SVIELCOM/MWE_Schema_and_PCB/Parts.txt

TLV9001IDBVR			done
B82790C0225N265			done поправить футпринт и 3D
RID-50B  
SC56-11SRWA 			done
MAX7219EWG+T  			done
PST-11A  			done
LD1117S33CTR			done  	
593D106X9016A2TE3 10x16		done
CL10B105KA8NNNC 1x25		done
STM32H743ZIT6  			done
CC56-12SURKWA  			done
ISO224BDWVR  
ESDA6V1BC6 			done
NX3215SA-32.768K-STD-MUA-14	done
NX5032GA-8MHz			done
TR3D476K025C0150 47x25		done
TMH 2415S 			done		
BC56-11SURKWA			done
W25Q256JVFIQ			done
GRM188R7YA105KA12D 1x35		done
CC0603BRNPO9BN2R7 2.7pF		done
L-1154ID			done
593D476X9016D2TE3 47x16		done
ISO1211DR 			done
LAN8742A-CZ-TR			done
