SVIELCOM/MWE_Schema_and_PCB/Analog_decoupling.ods

"U2" | "ISO224ADWVR" | ""
"J1" | "22-23-2021" | ""
"U5" | "ISO224ADWVR" | ""
"J2" | "22-23-2021" | ""
"U9" | "ISO224ADWVR" | ""
"J3" | "22-23-2021" | ""
"J4" | "302-S101" | ""
"J5" | "OSTTC020162" | ""
"C2" | "10µFx35" | "293D106X9035D2TE3"
"C21" | "10µFx35" | "293D106X9035D2TE3"
"C12" | "10µFx35" | "293D106X9035D2TE3"
"C4" | "10µFx35" | "293D106X9035D2TE3"
"C6" | "10µFx16" | "593D106X9016A2TE3"
"L1" | "B82790C0225N265" | "B82790C0225N265"
"L2" | "B82790C0225N265" | "B82790C0225N265"
"L3" | "B82790C0225N265" | "B82790C0225N265"
"C8" | "0.22µF" | "C1608X7R1H224K080AB"
"C15" | "0.22µF" | "C1608X7R1H224K080AB"
"C24" | "0.22µF" | "C1608X7R1H224K080AB"
"C7" | "0.1µF" | "CL10B104KC8NNNC"
"C14" | "0.1µF" | "CL10B104KC8NNNC"
"C23" | "0.1µF" | "CL10B104KC8NNNC"
"C18" | "1µF" | "CL10B105KA8NNNC"
"C3" | "1µF" | "GRM188R7YA105KA12D"
"C1" | "1µF" | "GRM188R7YA105KA12D"
"C5" | "1µF" | "GRM188R7YA105KA12D"
"C11" | "1µF" | "GRM188R7YA105KA12D"
"C10" | "1µF" | "GRM188R7YA105KA12D"
"C13" | "1µF" | "GRM188R7YA105KA12D"
"C20" | "1µF" | "GRM188R7YA105KA12D"
"C19" | "1µF" | "GRM188R7YA105KA12D"
"C22" | "1µF" | "GRM188R7YA105KA12D"
"C17" | "1µF" | "GRM188R7YA105KA12D"
"R3" | "1K" | "MFR-25FTF52-1K"
"R17" | "1K" | "MFR-25FTF52-1K"
"R31" | "1K" | "MFR-25FTF52-1K"
"R2" | "825" | "RC0603FR-07825RL"
"R7" | "825" | "RC0603FR-07825RL"
"R16" | "825" | "RC0603FR-07825RL"
"R30" | "825" | "RC0603FR-07825RL"
"R21" | "825" | "RC0603FR-07825RL"
"R35" | "825" | "RC0603FR-07825RL"
"R5" | "1.1K" | "RC0805FR-071K1L"
"R19" | "1.1K" | "RC0805FR-071K1L"
"R33" | "1.1K" | "RC0805FR-071K1L"
"R14" | "1K" | "RC0805FR-071KL"
"R13" | "1K" | "RC0805FR-071KL"
"R12" | "1K" | "RC0805FR-071KL"
"R28" | "1K" | "RC0805FR-071KL"
"R27" | "1K" | "RC0805FR-071KL"
"R26" | "1K" | "RC0805FR-071KL"
"R42" | "1K" | "RC0805FR-071KL"
"R41" | "1K" | "RC0805FR-071KL"
"R40" | "1K" | "RC0805FR-071KL"
"R11" | "2K" | "RC0805FR-072KL"
"R25" | "2K" | "RC0805FR-072KL"
"R39" | "2K" | "RC0805FR-072KL"
"R10" | "3.3K" | "RT0603BRD073K3L"
"R1" | "3.3K" | "RT0603BRD073K3L"
"R15" | "3.3K" | "RT0603BRD073K3L"
"R29" | "3.3K" | "RT0603BRD073K3L"
"R24" | "3.3K" | "RT0603BRD073K3L"
"R38" | "3.3K" | "RT0603BRD073K3L"
"R4" | "10K" | "RT0805BRB0710KL"
"R6" | "10K" | "RT0805BRB0710KL"
"R8" | "10K" | "RT0805BRB0710KL"
"R9" | "10K" | "RT0805BRB0710KL"
"R18" | "10K" | "RT0805BRB0710KL"
"R20" | "10K" | "RT0805BRB0710KL"
"R22" | "10K" | "RT0805BRB0710KL"
"R23" | "10K" | "RT0805BRB0710KL"
"R32" | "10K" | "RT0805BRB0710KL"
"R34" | "10K" | "RT0805BRB0710KL"
"R36" | "10K" | "RT0805BRB0710KL"
"R37" | "10K" | "RT0805BRB0710KL"
"U4" | "TLV9001IDBVR"
"PS1" | "TMH2415S"
"U1" | "LT1129CST-5#PBF"
"U8" | "REF1933AIDDCT"
"D2" | "1N4743A"
"D1" | "1N4743A"
"U3" | "TLV9001IDBVR"
"U7" | "TLV9001IDBVR"
"PS2" | "TMH2415S"
"U6" | "TLV9001IDBVR"
"U11" | "TLV9001IDBVR"
"PS3" | "TMH2415S"
"U10" | "TLV9001IDBVR"
"D4" | "1N4743A"
"D3" | "1N4743A"
"D6" | "1N4743A"
"D5" | "1N4743A"
