SVIELCOM/MWE_Schema_and_PCB/Schema_and_PCB.ods

U11 | "STM32H743ZIT6" | ""
C1 | "10┬╡F" | "593D106X9016A2TE3"
C32 | "10┬╡F" | "593D106X9016A2TE3"
C34 | "10┬╡F" | "593D106X9016A2TE3"
C28 | "10┬╡F" | "593D106X9016A2TE3"
C12 | "10┬╡Fx16" | "593D106X9016A2TE3"
C16 | "10┬╡Fx16" | "593D106X9016A2TE3"
C9 | "10┬╡Fx16" | "593D106X9016A2TE3"
C8 | "10┬╡Fx16" | "593D106X9016A2TE3"
C51 | "10┬╡Fx16" | "593D106X9016A2TE3"
C88 | "10┬╡F" | "593D106X9016A2TE3"
C11 | "47┬╡Fx16" | "593D476X9016D2TE3"
C15 | "47┬╡Fx16" | "593D476X9016D2TE3"
L1 | "600R@100MHz" | "BK2125HS601-T"
L2 | "600R@100MHz" | "BK2125HS601-T"
L3 | "600R@100MHz" | "BK2125HS601-T"
L6 | "600R@100MHz" | "BK2125HS601-T"
C7 | "2.7pF" | "CC0603BRNPO9BN2R7"
C10 | "2.7pF" | "CC0603BRNPO9BN2R7"
C5 | "4.6pF" | "CC0603CRNPO9BN4R7"
C6 | "4.6pF" | "CC0603CRNPO9BN4R7"
C95 | "5.6pF" | "CC0603CRNPO9BN5R6"
C92 | "5.6pF" | "CC0603CRNPO9BN5R6"
C14 | "0.1┬╡F" | "CL10B104KC8NNNC"
C54 | "0.1┬╡F" | "CL10B104KC8NNNC"
C66 | "0.1┬╡F" | "CL10B104KC8NNNC"
C74 | "0.1┬╡F" | "CL10B104KC8NNNC"
C79 | "0.1┬╡F" | "CL10B104KC8NNNC"
C80 | "0.1┬╡F" | "CL10B104KC8NNNC"
C81 | "0.1┬╡F" | "CL10B104KC8NNNC"
C82 | "0.1┬╡F" | "CL10B104KC8NNNC"
C83 | "0.1┬╡F" | "CL10B104KC8NNNC"
C84 | "0.1┬╡F" | "CL10B104KC8NNNC"
C43 | "1┬╡F" | "CL10B105KA8NNNC"
C44 | "1┬╡F" | "CL10B105KA8NNNC"
C2 | "1┬╡F" | "CL10B105KA8NNNC"
C31 | "1┬╡F" | "CL10B105KA8NNNC"
C33 | "1┬╡F" | "CL10B105KA8NNNC"
C18 | "1┬╡F" | "CL10B105KA8NNNC"
C19 | "1┬╡F" | "CL10B105KA8NNNC"
C20 | "1┬╡F" | "CL10B105KA8NNNC"
C21 | "1┬╡F" | "CL10B105KA8NNNC"
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
R110 | "50K"
R107 | "50K"
R108 | "50K"
R23 | "82K"
R27 | "15K"
R57 | "10K"
R61 | "10K"
BT1 | "CR2032"
U4 | "BC56-12SURKWA"
U14 | "SN74AVCA406DGGR"
U9 | "ST1L05APU33R"
TP4 | "TestPoint"
TP2 | "TestPoint"
TP3 | "TestPoint"
TP1 | "TestPoint"
TP7 | "TestPoint"
TP16 | "TestPoint"
TP19 | "TestPoint"
