SVIELCOM/MWE_Schema_and_PCB/(list of files, drawings)

Other design files:
PCB.dsn
