SVIELCOM/MWE_Schema_and_PCB/Analog_decoupling.kicad_pcb

## KiCad design Analog_decoupling.kicad_pcb (2022-03-23)

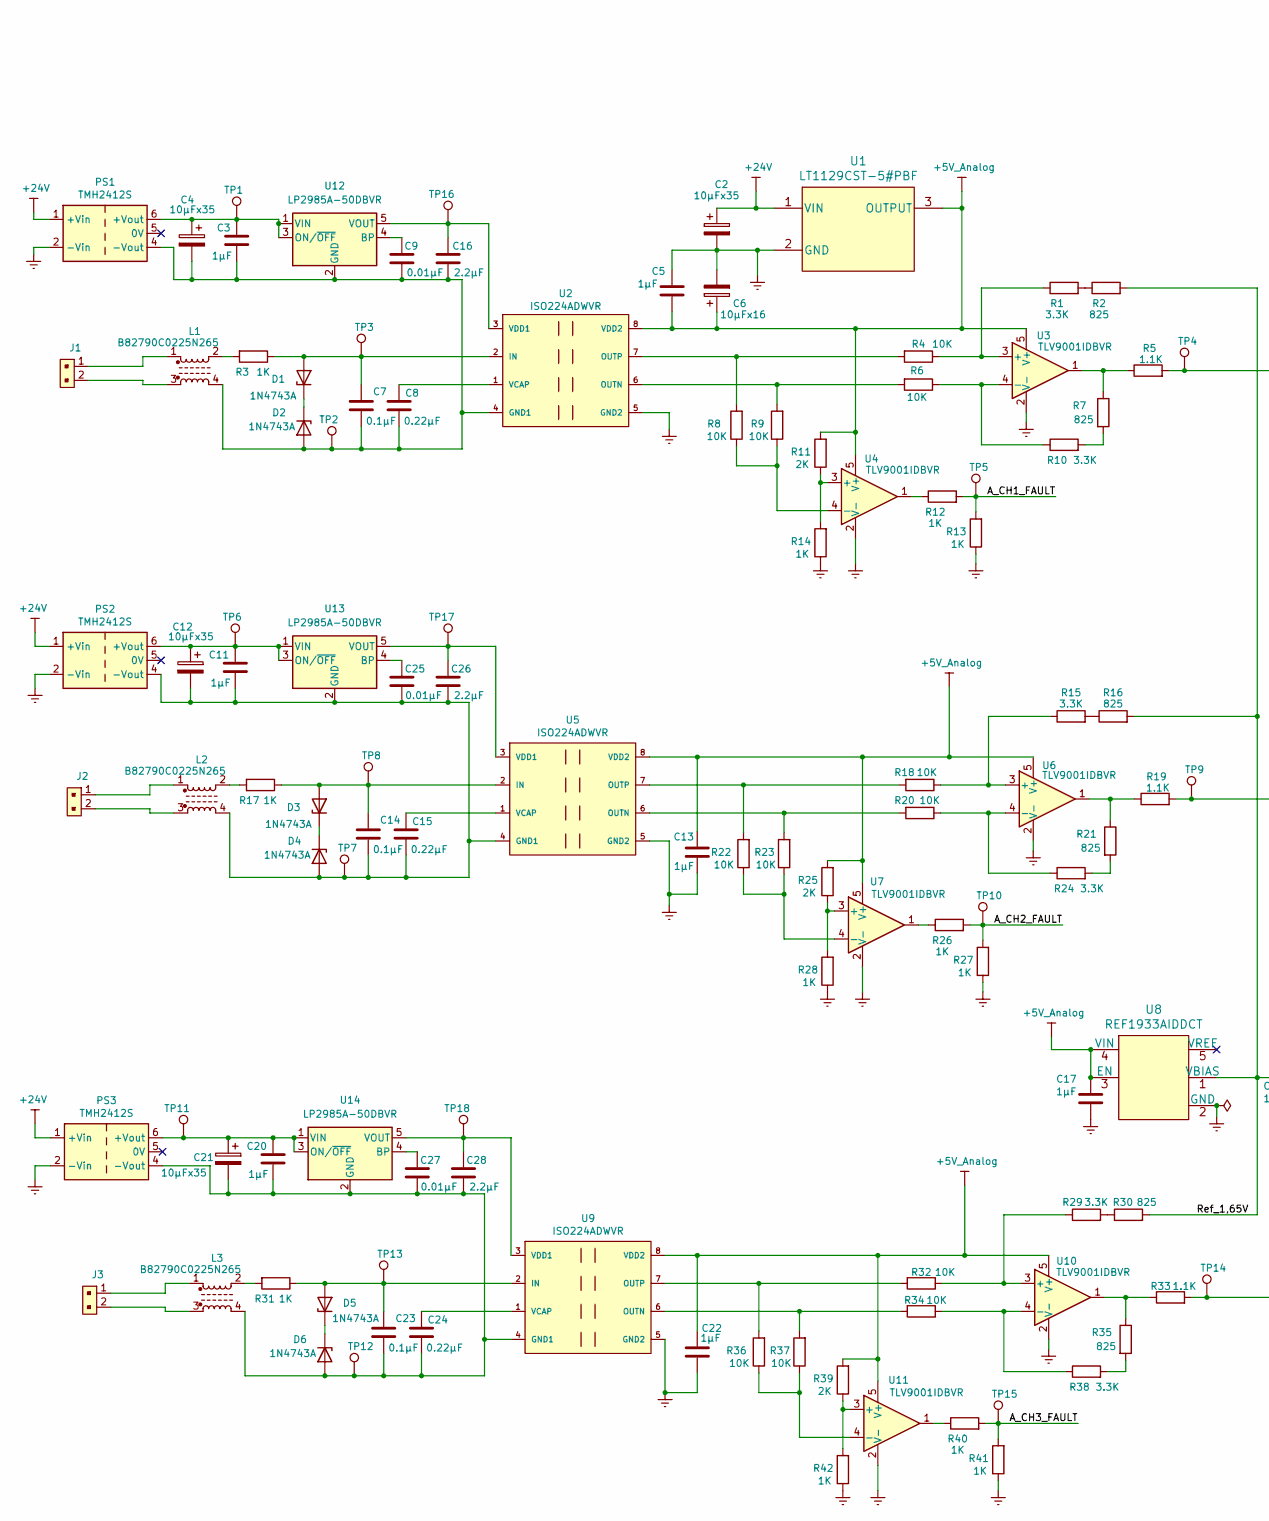
[picture p1: schematic Analog_decoupling.kicad_sch, ШВУ, part in row 1, column 1]

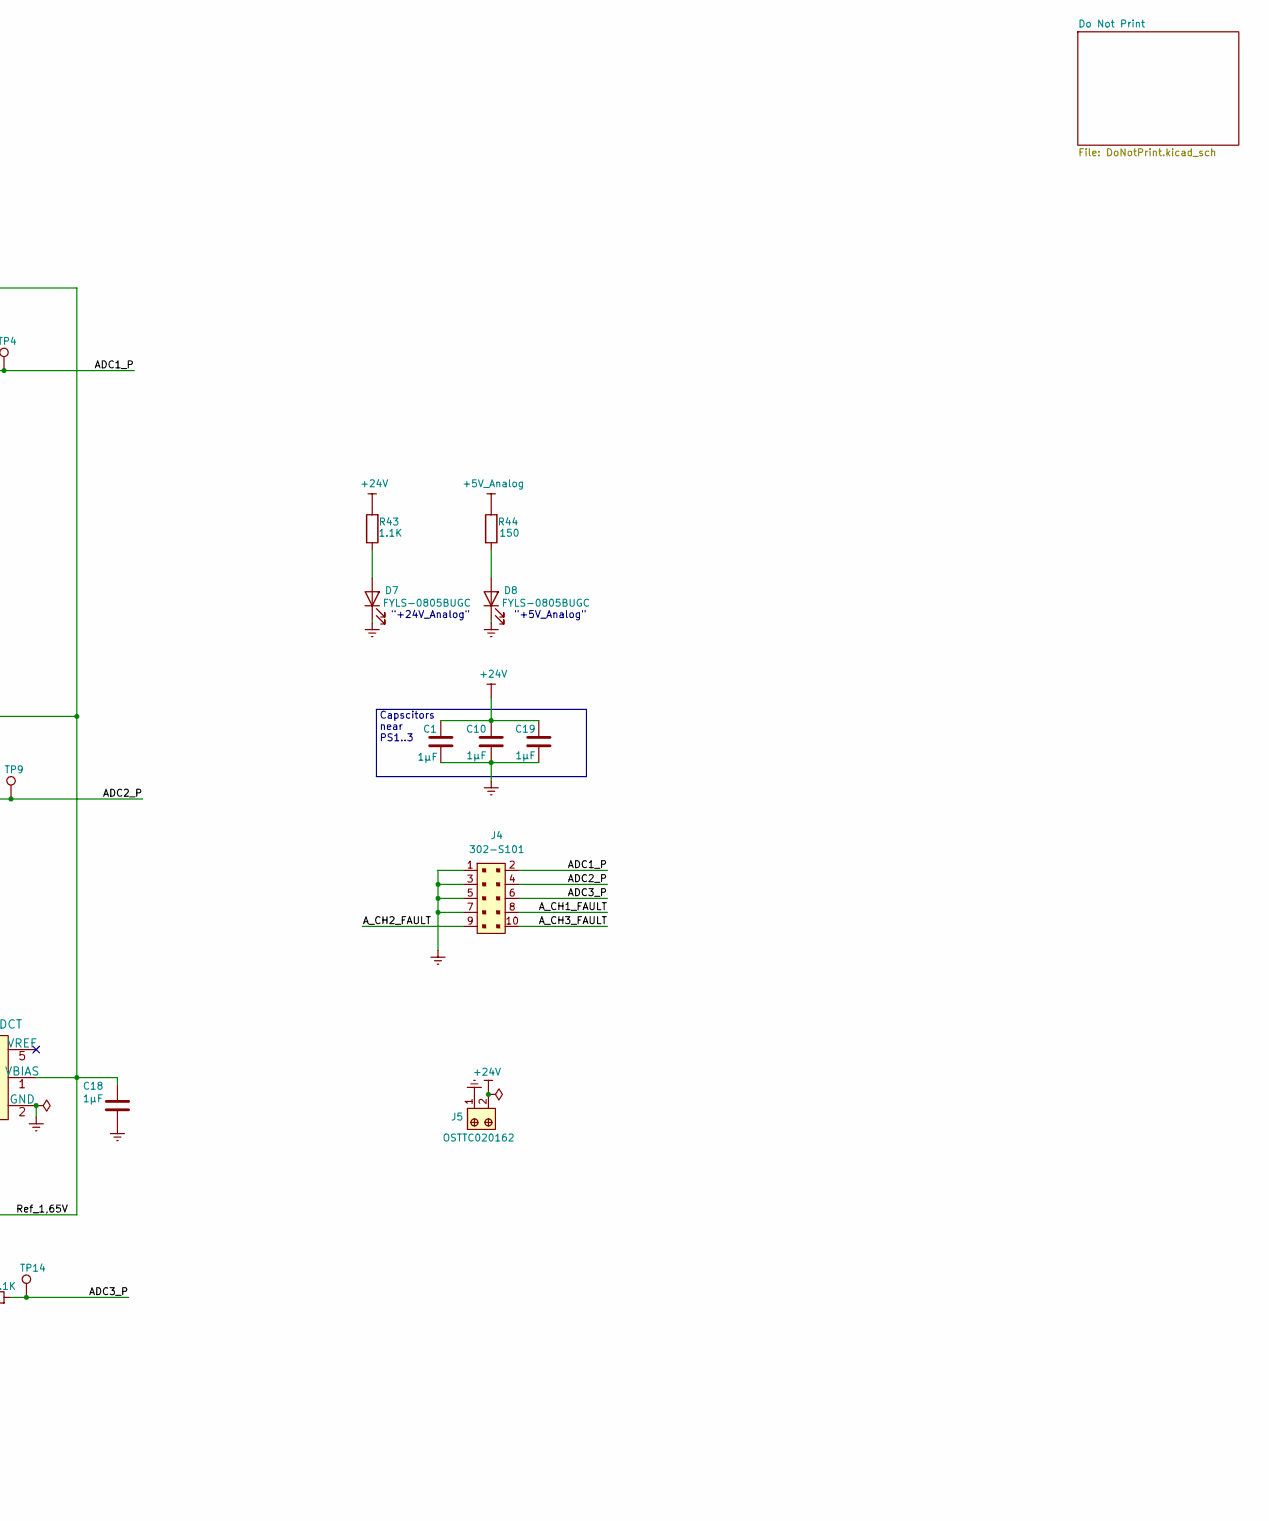
[picture p2: schematic Analog_decoupling.kicad_sch, ШВУ, part in row 1, column 2]

Parts:
C1, C3, C5, C10, C11, C13, C17, C18, C19, C20, C22: 1µF; C_0603_1608Metric_Pad1.08x0.95mm_HandSolder
C2, C4, C12, C21: 10µFx35; CP_EIA-7343-30_AVX-N_Pad2.25x2.55mm_HandSolder
C6: 10µFx16; CP_EIA-3216-10_Kemet-I
C7, C14, C23: 0.1µF; C_0603_1608Metric_Pad1.08x0.95mm_HandSolder
C8, C15, C24: 0.22µF; C_0603_1608Metric_Pad1.08x0.95mm_HandSolder
C9, C25, C27: 0.01µF; C_0603_1608Metric
C16, C26, C28: 2.2µF; C_0603_1608Metric
D1, D2, D3, D4, D5, D6: 1N4743A; D_DO-41_SOD81_P10.16mm_Horizontal
D7, D8: FYLS-0805BUGC; LED_0805_2012Metric
J1, J2, J3: 22-23-2021; PinHeader_1x2_P2.54mm_Drill1.02mm; MPN 22-23-2021; Digi-Key_PN WM4200-ND
J4: 302-S101; PinHeader_2x5_P2.54mm_Drill1.2mm; MPN 302-S101; Digi-Key_PN ED1543-ND
J5: OSTTC020162; Term_Block_1x2_P5mm; MPN OSTTC020162; Digi-Key_PN ED2600-ND
L1, L2, L3: B82790C0225N265
PS1, PS2, PS3: TMH2412S; Converter_DCDC_XP_POWER-IAxxxxS_THT
R1, R10, R15, R24, R29, R38: 3.3K; R_0603_1608Metric
R2, R7, R16, R21, R30, R35: 825; R_0603_1608Metric
R3, R17, R31: 1K; R_Axial_DIN0207_L6.3mm_D2.5mm_P10.16mm_Horizontal
R4, R6, R8, R9, R18, R20, R22, R23, R32, R34, R36, R37: 10K; R_0805_2012Metric
R5, R19, R33, R43: 1.1K; R_0805_2012Metric
R11, R25, R39: 2K; R_0805_2012Metric
R12, R13, R14, R26, R27, R28, R40, R41, R42: 1K; R_0805_2012Metric
R44: 150; R_0805_2012Metric
TP1, TP2, TP3, TP4, TP5, TP6, TP7, TP8, TP9, TP10, TP11, TP12, TP13, TP14, TP15, TP16, TP17, TP18: TestPoint; TestPoint_Pad_D1.5mm
U1: LT1129CST-5#PBF; SOT-223-3_TabPin2
U2, U5, U9: ISO224ADWVR; Texas_Instruments-DWV0008A-0-0-IPC_A; voltage gain 0.001/3V/mV; mouser part number 595-ISO224ADWVR; digikey description IC ISOLATED 8SOIC
U3, U4, U6, U7, U10, U11: TLV9001IDBVR; SOT-23-5
U8: REF1933AIDDCT; SOT-23-5_HandSoldering
U12, U13, U14: LP2985A-50DBVR; SOT-23-5

Connections:
+5V_Analog: C5.2, C6.1, C13.2, C17.1, C22.2, R11.2, R25.2, R39.2, R44.2, U1.3 (OUTPUT), U2.8 (VDD2), U3.5 (V+), U4.5 (V+), U5.8 (VDD2), U6.5 (V+), U7.5 (V+), U8.3 (EN), U8.4 (VIN), U9.8 (VDD2), U10.5 (V+), U11.5 (V+)
+24V: C1.1, C2.1, C10.1, C19.1, J5.2, PS1.1 (+Vin), PS2.1 (+Vin), PS3.1 (+Vin), R43.2, U1.1 (VIN)
/ADC1_P: J4.2, R5.2, TP4.1
/ADC2_P: J4.4, R19.2, TP9.1
/ADC3_P: J4.6, R33.2, TP14.1
/A_CH1_FAULT: J4.8, R12.2, R13.2, TP5.1
/A_CH2_FAULT: J4.9, R26.2, R27.2, TP10.1
/A_CH3_FAULT: J4.10, R40.2, R41.2, TP15.1
/Ref_1,65V: C18.1, R2.2, R16.2, R30.2, U8.1 (VBIAS)
GNDREF: C1.2, C2.2, C5.1, C6.2, C10.2, C13.1, C17.2, C18.2, C19.2, C22.1, D7.1 (K), D8.1 (K), J4.1, J4.3, J4.5, J4.7, J5.1, PS1.2 (-Vin), PS2.2 (-Vin), PS3.2 (-Vin), R13.1, R14.1, R27.1, R28.1, R41.1, R42.1, U1.2 (GND), U2.5 (GND2), U3.2 (V-), U4.2 (V-), U5.5 (GND2), U6.2 (V-), U7.2 (V-), U8.2 (GND), U9.5 (GND2), U10.2 (V-), U11.2 (V-)
unnamed: C3.1, C4.1, PS1.6 (+Vout), TP1.1, U12.1 (VIN), U12.3 (ON/~OFF)
unnamed: C7.1, D1.2 (A), R3.1, TP3.1, U2.2 (IN)
unnamed: C8.1, U2.1 (VCAP)
unnamed: C9.1, U12.4 (BP)
unnamed: C11.1, C12.1, PS2.6 (+Vout), TP6.1, U13.1 (VIN), U13.3 (ON/~OFF)
unnamed: C11.2, C12.2, C14.2, C15.2, C25.2, C26.2, D4.2 (A), L2.4, PS2.4 (-Vout), TP7.1, U5.4 (GND1), U13.2 (GND)
unnamed: C14.1, D3.2 (A), R17.1, TP8.1, U5.2 (IN)
unnamed: C15.1, U5.1 (VCAP)
unnamed: C16.1, TP16.1, U2.3 (VDD1), U12.5 (VOUT)
unnamed: C3.2, C4.2, C7.2, C8.2, C9.2, C16.2, D2.2 (A), L1.4, PS1.4 (-Vout), TP2.1, U2.4 (GND1), U12.2 (GND)
unnamed: C20.1, C21.1, PS3.6 (+Vout), TP11.1, U14.1 (VIN), U14.3 (ON/~OFF)
unnamed: C20.2, C21.2, C23.2, C24.2, C27.2, C28.2, D6.2 (A), L3.4, PS3.4 (-Vout), TP12.1, U9.4 (GND1), U14.2 (GND)
unnamed: C23.1, D5.2 (A), R31.1, TP13.1, U9.2 (IN)
unnamed: C24.1, U9.1 (VCAP)
unnamed: C25.1, U13.4 (BP)
unnamed: C26.1, TP17.1, U5.3 (VDD1), U13.5 (VOUT)
unnamed: C27.1, U14.4 (BP)
unnamed: C28.1, TP18.1, U9.3 (VDD1), U14.5 (VOUT)
unnamed: D1.1 (K), D2.1 (K)
unnamed: D3.1 (K), D4.1 (K)
unnamed: D5.1 (K), D6.1 (K)
unnamed: D7.2 (A), R43.1
unnamed: D8.2 (A), R44.1
unnamed: J1.1, L1.1
unnamed: J1.2, L1.3
unnamed: J2.1, L2.1
unnamed: J2.2, L2.3
unnamed: J3.1, L3.1
unnamed: J3.2, L3.3
unnamed: L1.2, R3.2
unnamed: L2.2, R17.2
unnamed: L3.2, R31.2
unnamed: R1.1, R4.1, U3.3 (+)
unnamed: R1.2, R2.1
unnamed: R4.2, R8.2, U2.7 (OUTP)
unnamed: R5.1, R7.1, U3.1
unnamed: R6.2, R9.2, U2.6 (OUTN)
unnamed: R8.1, R9.1, U4.4 (-)
unnamed: R6.1, R10.1, U3.4 (-)
unnamed: R7.2, R10.2
unnamed: R11.1, R14.2, U4.3 (+)
unnamed: R12.1, U4.1
unnamed: R15.1, R18.1, U6.3 (+)
unnamed: R15.2, R16.1
unnamed: R18.2, R22.2, U5.7 (OUTP)
unnamed: R19.1, R21.1, U6.1
unnamed: R20.1, R24.1, U6.4 (-)
unnamed: R20.2, R23.2, U5.6 (OUTN)
unnamed: R21.2, R24.2
unnamed: R22.1, R23.1, U7.4 (-)
unnamed: R25.1, R28.2, U7.3 (+)
unnamed: R26.1, U7.1
unnamed: R29.1, R32.1, U10.3 (+)
unnamed: R29.2, R30.1
unnamed: R32.2, R36.2, U9.7 (OUTP)
unnamed: R33.1, R35.1, U10.1
unnamed: R34.1, R38.1, U10.4 (-)
unnamed: R34.2, R37.2, U9.6 (OUTN)
unnamed: R35.2, R38.2
unnamed: R36.1, R37.1, U11.4 (-)
unnamed: R39.1, R42.2, U11.3 (+)
unnamed: R40.1, U11.1

Notes on the sheet:
"+24V_Analog"
Capscitors near PS1..3
"+5V_Analog"

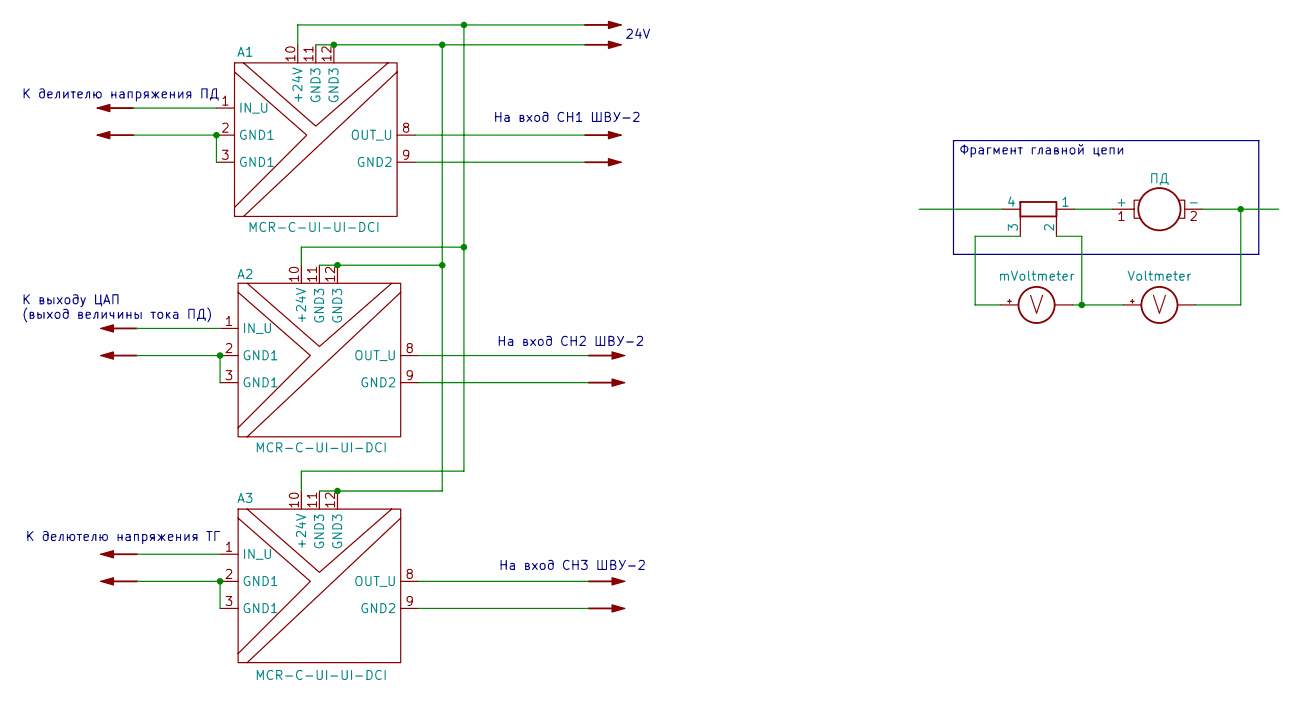
[picture p3: schematic DoNotPrint.kicad_sch]

Parts:
A1, A2, A3: MCR-C-UI-UI-DCI
M1: ПД
MES1: mVoltmeter
MES2: Voltmeter
R45: R_Shunt

Connections:
unnamed: A1.2 (GND1), A1.3 (GND1)
unnamed: A1.10 (+24V), A2.10 (+24V), A3.10 (+24V)
unnamed: A1.11 (GND3), A1.12 (GND3), A2.11 (GND3), A2.12 (GND3), A3.11 (GND3), A3.12 (GND3)
unnamed: A2.2 (GND1), A2.3 (GND1)
unnamed: A3.2 (GND1), A3.3 (GND1)
unnamed: M1.1 (+), R45.1
unnamed: M1.2 (-), MES2.1 (-)
unnamed: MES1.1 (-), MES2.2 (+), R45.2
unnamed: MES1.2 (+), R45.3

Notes on the sheet:
На вход CH3 ШВУ-2
24V
На вход CH1 ШВУ-2
На вход CH2 ШВУ-2
К делютелю напряжения ТГ
К делителю напряжения ПД
К выходу ЦАП (выход величины тока ПД)
Фрагмент главной цепи

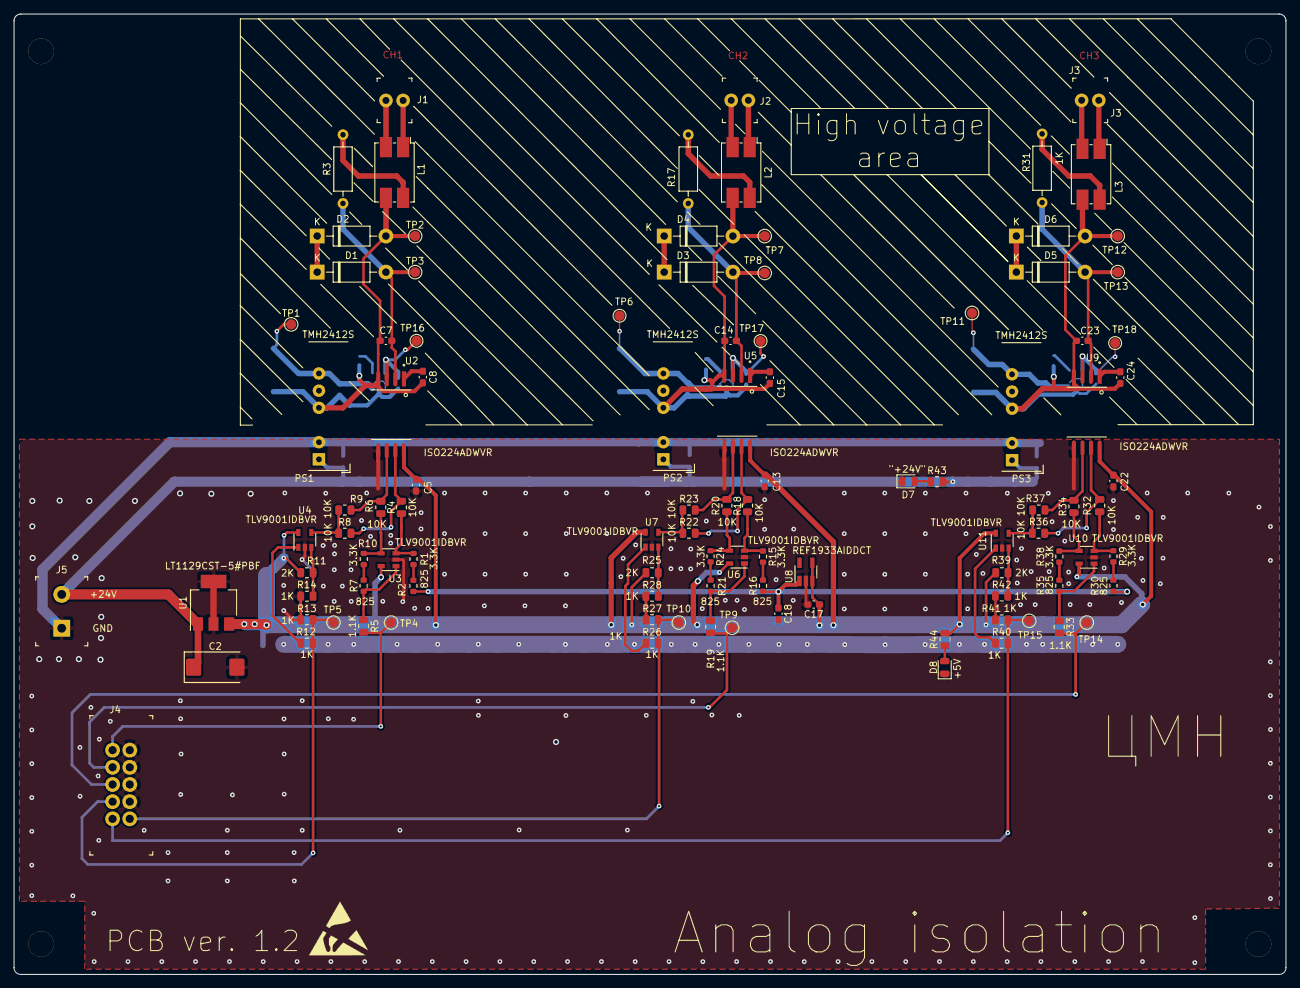
[picture p4: board Analog_decoupling.kicad_pcb from above]

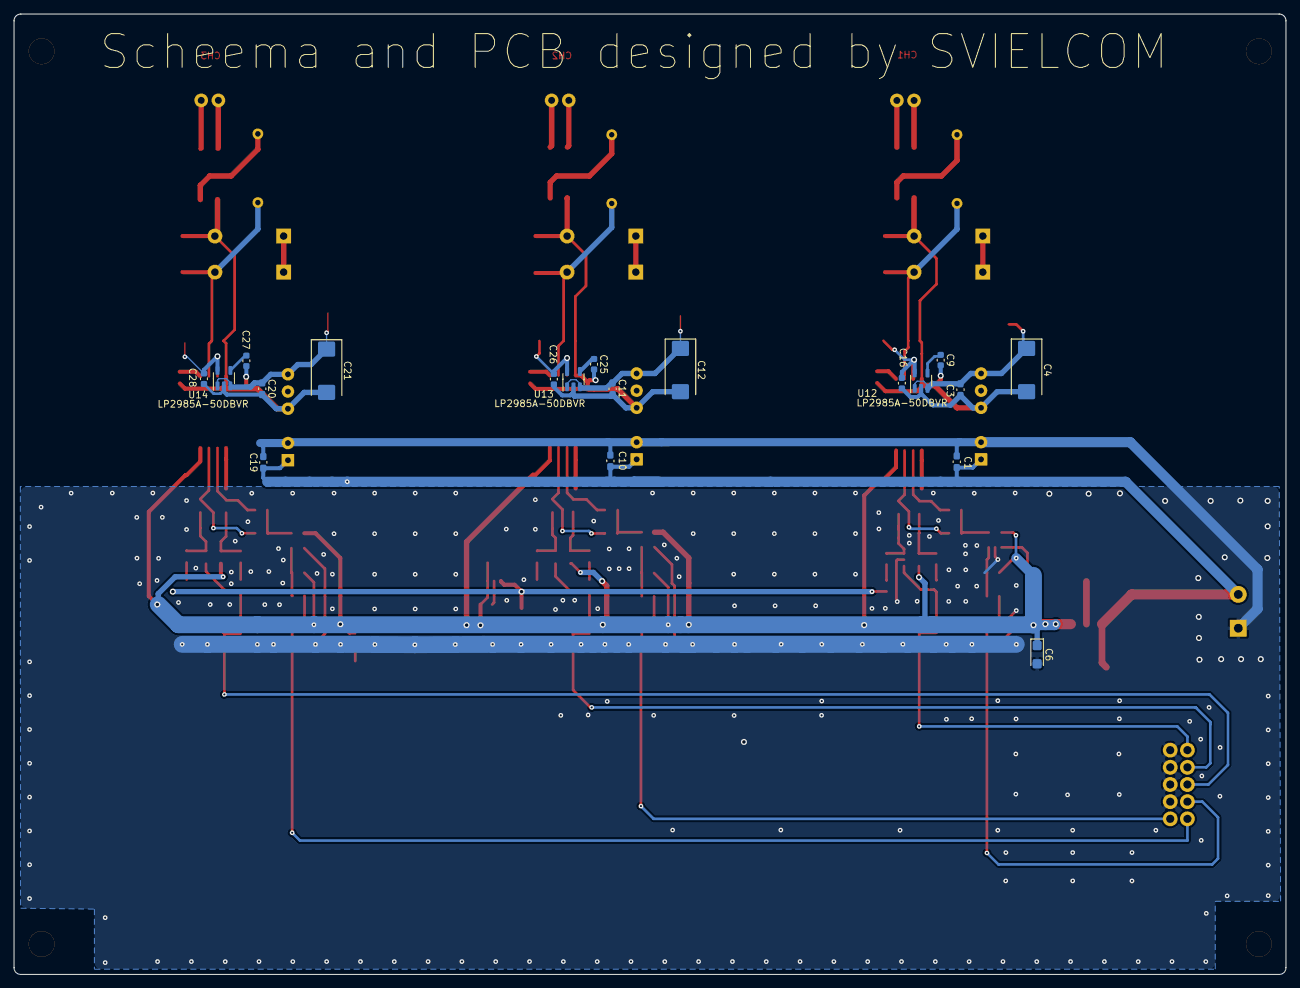
[picture p5: board Analog_decoupling.kicad_pcb from below]

Board: 2 copper layers, 188.1 x 142.0 mm, 123 parts (19 on the bottom side), 72 nets.
