SVIELCOM/MWE_Schema_and_PCB/Schema_and_PCB.kicad_pcb

## KiCad design Schema_and_PCB.kicad_pcb (2021-12-13)

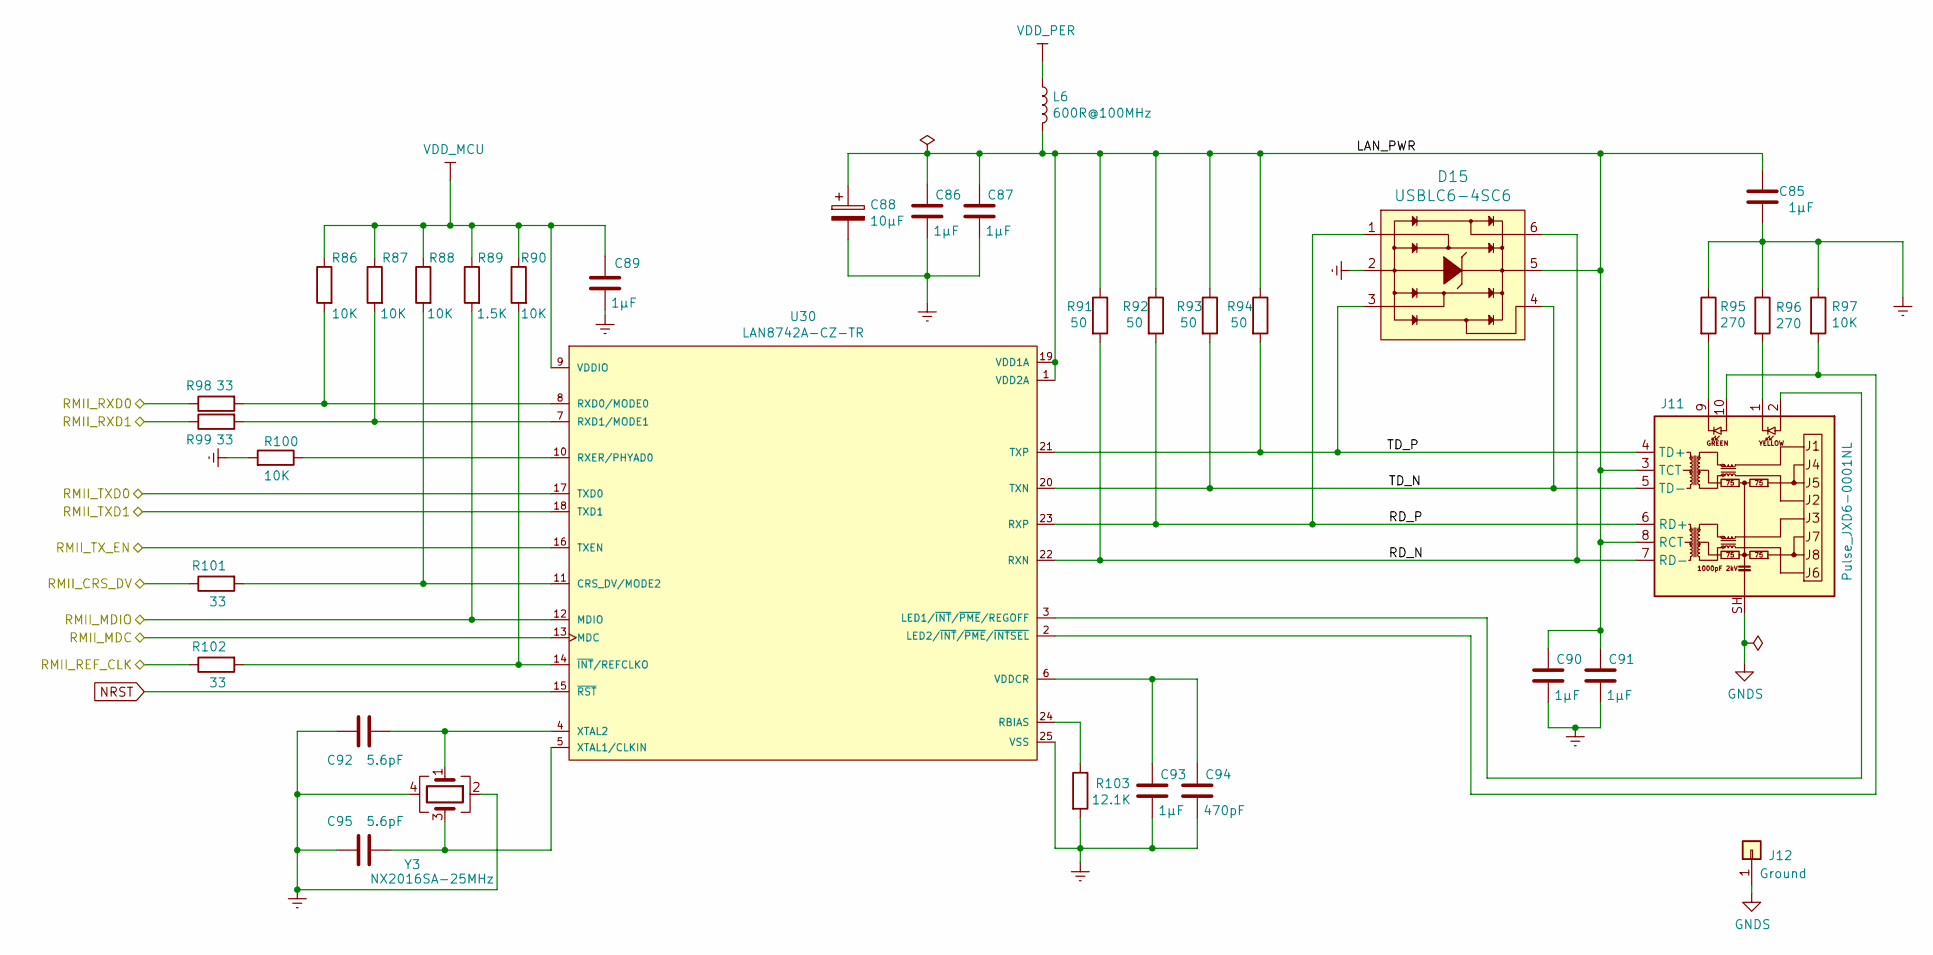
[picture p6: schematic LAN.kicad_sch, ШВУ]

Parts:
C85, C86, C87, C89, C90, C91, C93: 1µF; C_0603_1608Metric_Pad1.08x0.95mm_HandSolder
C88: 10µF; CP_EIA-3216-10_Kemet-I
C92, C95: 5.6pF; C_0603_1608Metric_Pad1.08x0.95mm_HandSolder
C94: 470pF; C_0603_1608Metric_Pad1.08x0.95mm_HandSolder
D15: USBLC6-4SC6; SOT-23-6_Handsoldering; MPN USBLC6-4SC6; Digi-Key_PN 497-4492-1-ND
J11: Pulse_JXD6-0001NL; RJ45_Pulse_JXD6-0001NL_Horizontal
J12: Ground; PinHeader_1x01_P2.54mm_Vertical
L6: 600R@100MHz; L_0805_2012Metric_Pad1.15x1.40mm_HandSolder
R86, R87, R90, R97, R100: 10K; R_0805_2012Metric_Pad1.20x1.40mm_HandSolder
R88: 10K; R_0805_2012Metric
R89: 1.5K; R_0805_2012Metric_Pad1.20x1.40mm_HandSolder
R91, R92, R93, R94: 50; R_0603_1608Metric_Pad0.98x0.95mm_HandSolder
R95, R96: 270; R_0805_2012Metric_Pad1.20x1.40mm_HandSolder
R98, R99, R101, R102: 33; R_0805_2012Metric_Pad1.20x1.40mm_HandSolder
R103: 12.1K; R_0805_2012Metric_Pad1.20x1.40mm_HandSolder
U30: LAN8742A-CZ-TR; Microchip-C04-143B-S4QFN-0-0-IPC_A; mouser part number 579-LAN8742A-CZ-TR; digikey description IC TRANSCEIVER 1/1 24SQFN
Y3: NX2016SA-25MHz; Crystal_SMD_2016-4Pin_2.0x1.6mm

Connections:
/LAN/LAN_PWR: C85.2, C86.1, C87.1, C88.1, C90.1, C91.1, D15.5, J11.3 (TCT), J11.8 (RCT), L6.2, R91.1, R92.1, R93.1, R94.1, U30.1 (VDD2A), U30.19 (VDD1A)
/LAN/RD_N: D15.6, J11.7 (RD-), R91.2, U30.22 (RXN)
/LAN/RD_P: D15.1, J11.6 (RD+), R92.2, U30.23 (RXP)
/LAN/RMII_CRS_DV: R101.1; also elsewhere on the board
/LAN/RMII_MDC: U30.13 (MDC); also elsewhere on the board
/LAN/RMII_MDIO: R89.2, U30.12 (MDIO); also elsewhere on the board
/LAN/RMII_REF_CLK: R102.1; also elsewhere on the board
/LAN/RMII_RXD0: R98.1; also elsewhere on the board
/LAN/RMII_RXD1: R99.1; also elsewhere on the board
/LAN/RMII_TXD0: U30.17 (TXD0); also elsewhere on the board
/LAN/RMII_TXD1: U30.18 (TXD1); also elsewhere on the board
/LAN/RMII_TX_EN: U30.16 (TXEN); also elsewhere on the board
/LAN/TD_N: D15.4, J11.5 (TD-), R93.2, U30.20 (TXN)
/LAN/TD_P: D15.3, J11.4 (TD+), R94.2, U30.21 (TXP)
GNDREF: C85.1, C86.2, C87.2, C88.2, C89.1, C90.2, C91.2, C92.2, C93.2, C94.2, C95.2, D15.2, R95.1, R96.1, R97.1, R100.2, R103.2, U30.25 (VSS), Y3.2, Y3.4; also elsewhere on the board
GNDS: J11.SH, J12.1
NRST: U30.15 (~RST); also elsewhere on the board
unnamed: C92.1, U30.4 (XTAL2), Y3.1
unnamed: C93.1, C94.1, U30.6 (VDDCR)
unnamed: C95.1, U30.5 (XTAL1/CLKIN), Y3.3
unnamed: J11.1, R96.2
unnamed: J11.2, U30.3 (LED1/~INT/~PME/REGOFF)
unnamed: J11.9, R95.2
unnamed: J11.10, R97.2, U30.2 (LED2/~INT/~PME/~INTSEL)
unnamed: R86.2, R98.2, U30.8 (RXD0/MODE0)
unnamed: R87.2, R99.2, U30.7 (RXD1/MODE1)
unnamed: R100.1, U30.10 (RXER/PHYAD0)
unnamed: R88.2, R101.2, U30.11 (CRS_DV/MODE2)
unnamed: R90.2, R102.2, U30.14 (~INT/REFCLKO)
unnamed: R103.1, U30.24 (RBIAS)
VDD_MCU: C89.2, R86.1, R87.1, R88.1, R89.1, R90.1, U30.9 (VDDIO); also elsewhere on the board
VDD_PER: L6.1; also elsewhere on the board

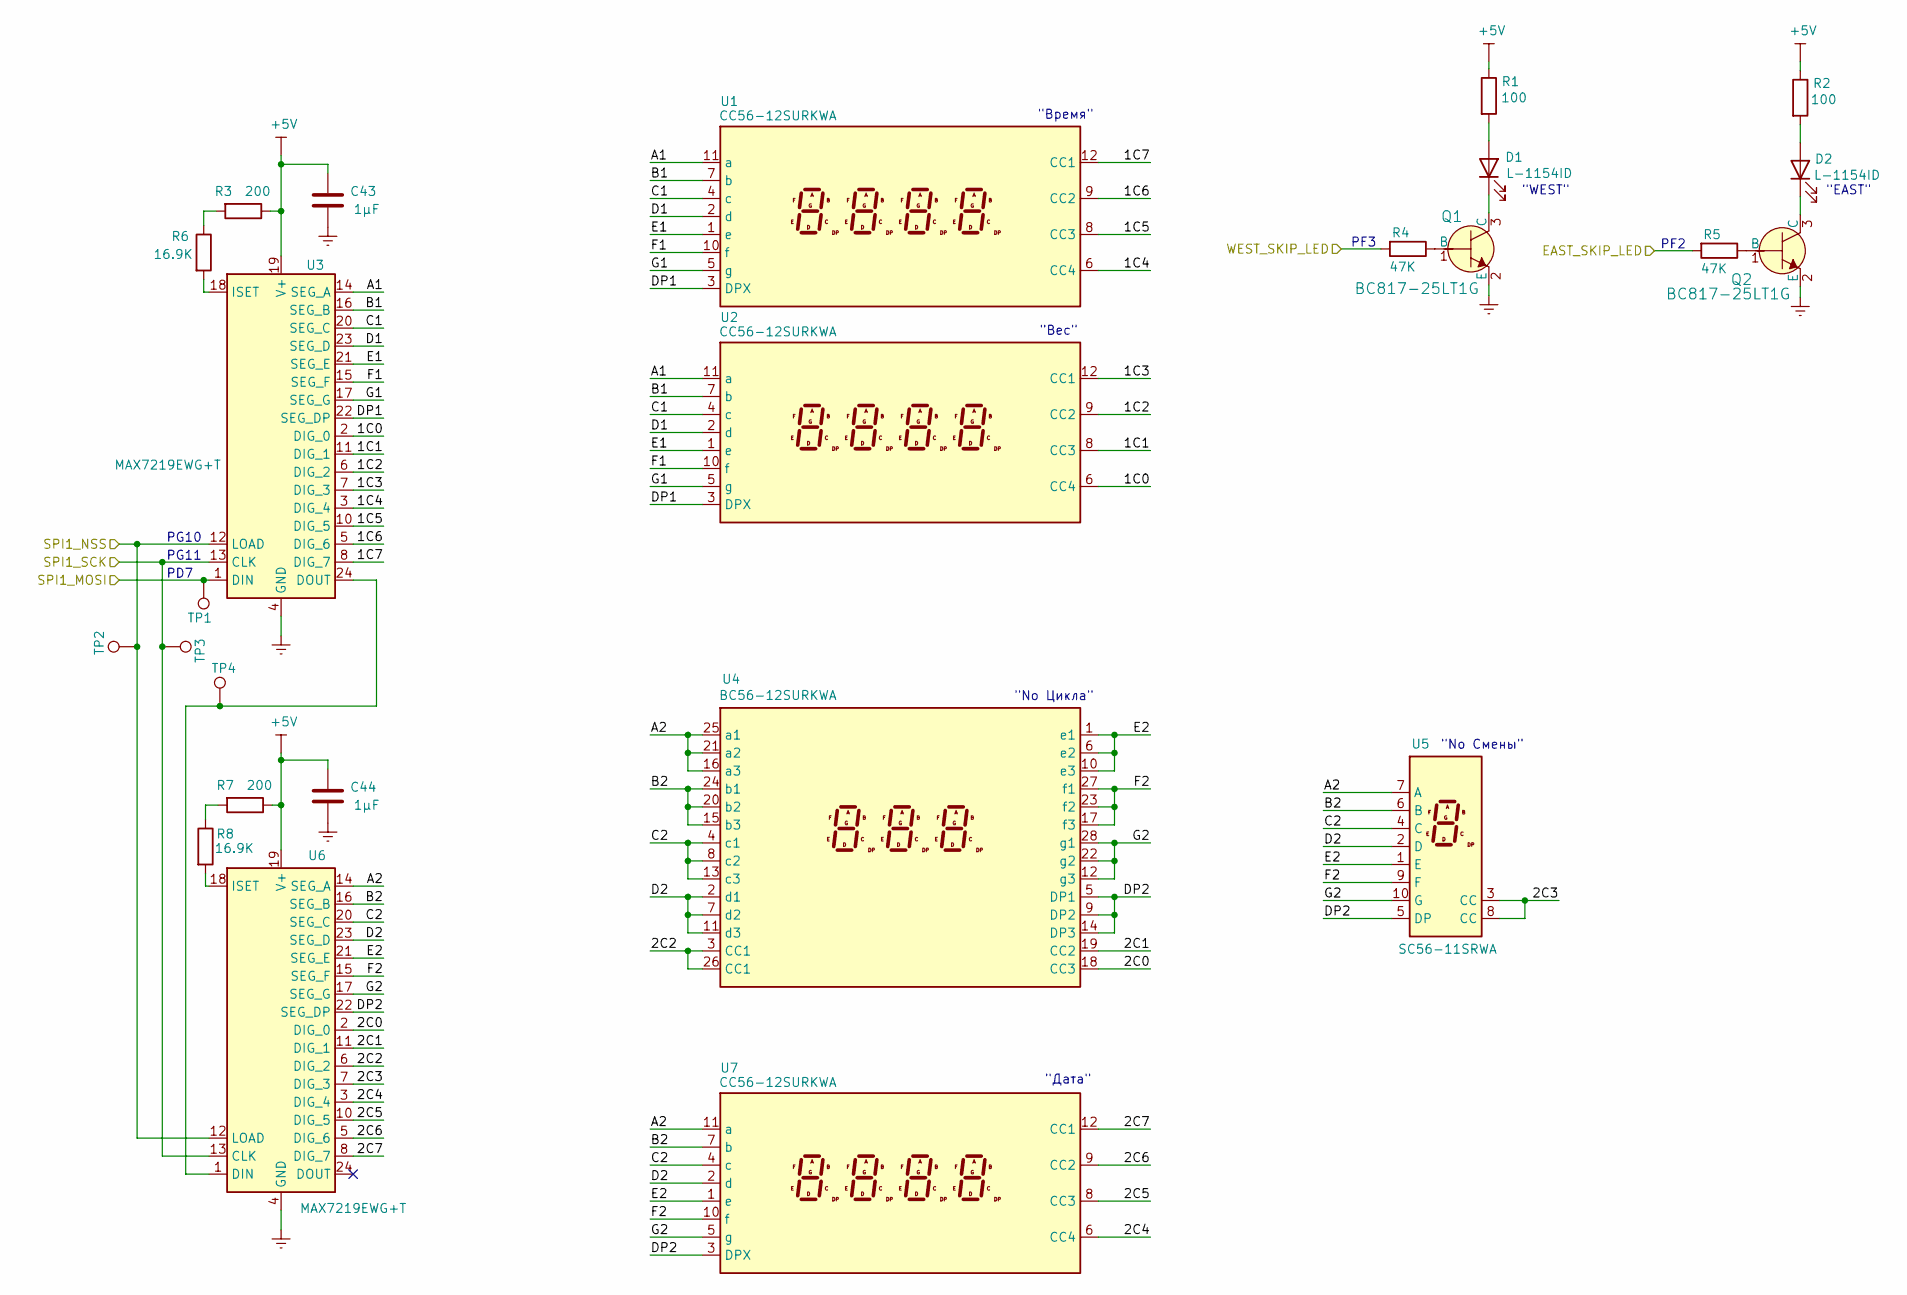
[picture p7: schematic Indicator.kicad_sch, ШВУ]

Parts:
C43, C44: 1µF; C_0603_1608Metric_Pad1.08x0.95mm_HandSolder
D1, D2: L-1154ID; LED_D3.0mm
Q1, Q2: BC817-25LT1G; SOT-23-3; MPN BC817-25LT1G; Digi-Key_PN BC817-25LT1GOSCT-ND
R1, R2: 100; R_0805_2012Metric_Pad1.20x1.40mm_HandSolder
R3, R7: 200; R_0805_2012Metric_Pad1.20x1.40mm_HandSolder
R4, R5: 47K; R_0805_2012Metric_Pad1.20x1.40mm_HandSolder
R6, R8: 16.9K; R_0805_2012Metric_Pad1.20x1.40mm_HandSolder
TP1, TP2, TP3, TP4: TestPoint; TestPoint_Pad_D1.5mm
U1, U2, U7: CC56-12SURKWA; CA56-12SURKWA
U3, U6: MAX7219EWG+T; SOIC-24W_7.5x15.4mm_P1.27mm
U4: BC56-12SURKWA; BC56-11SURKWA
U5: SC56-11SRWA; 7SegmentLED_LTS6760_LTS6780

Connections:
/Indicator/1C0: U2.6 (CC4), U3.2 (DIG_0)
/Indicator/1C1: U2.8 (CC3), U3.11 (DIG_1)
/Indicator/1C2: U2.9 (CC2), U3.6 (DIG_2)
/Indicator/1C3: U2.12 (CC1), U3.7 (DIG_3)
/Indicator/1C4: U1.6 (CC4), U3.3 (DIG_4)
/Indicator/1C5: U1.8 (CC3), U3.10 (DIG_5)
/Indicator/1C6: U1.9 (CC2), U3.5 (DIG_6)
/Indicator/1C7: U1.12 (CC1), U3.8 (DIG_7)
/Indicator/2C0: U4.18 (CC3), U6.2 (DIG_0)
/Indicator/2C1: U4.19 (CC2), U6.11 (DIG_1)
/Indicator/2C2: U4.3 (CC1), U4.26 (CC1), U6.6 (DIG_2)
/Indicator/2C3: U5.3 (CC), U5.8 (CC), U6.7 (DIG_3)
/Indicator/2C4: U6.3 (DIG_4), U7.6 (CC4)
/Indicator/2C5: U6.10 (DIG_5), U7.8 (CC3)
/Indicator/2C6: U6.5 (DIG_6), U7.9 (CC2)
/Indicator/2C7: U6.8 (DIG_7), U7.12 (CC1)
/Indicator/A1: U1.11 (a), U2.11 (a), U3.14 (SEG_A)
/Indicator/A2: U4.16 (a3), U4.21 (a2), U4.25 (a1), U5.7 (A), U6.14 (SEG_A), U7.11 (a)
/Indicator/B1: U1.7 (b), U2.7 (b), U3.16 (SEG_B)
/Indicator/B2: U4.15 (b3), U4.20 (b2), U4.24 (b1), U5.6 (B), U6.16 (SEG_B), U7.7 (b)
/Indicator/C1: U1.4 (c), U2.4 (c), U3.20 (SEG_C)
/Indicator/C2: U4.4 (c1), U4.8 (c2), U4.13 (c3), U5.4 (C), U6.20 (SEG_C), U7.4 (c)
/Indicator/D1: U1.2 (d), U2.2 (d), U3.23 (SEG_D)
/Indicator/D2: U4.2 (d1), U4.7 (d2), U4.11 (d3), U5.2 (D), U6.23 (SEG_D), U7.2 (d)
/Indicator/DP1: U1.3 (DPX), U2.3 (DPX), U3.22 (SEG_DP)
/Indicator/DP2: U4.5 (DP1), U4.9 (DP2), U4.14 (DP3), U5.5 (DP), U6.22 (SEG_DP), U7.3 (DPX)
/Indicator/E1: U1.1 (e), U2.1 (e), U3.21 (SEG_E)
/Indicator/E2: U4.1 (e1), U4.6 (e2), U4.10 (e3), U5.1 (E), U6.21 (SEG_E), U7.1 (e)
/Indicator/EAST_SKIP_LED: R5.2; also elsewhere on the board
/Indicator/F1: U1.10 (f), U2.10 (f), U3.15 (SEG_F)
/Indicator/F2: U4.17 (f3), U4.23 (f2), U4.27 (f1), U5.9 (F), U6.15 (SEG_F), U7.10 (f)
/Indicator/G1: U1.5 (g), U2.5 (g), U3.17 (SEG_G)
/Indicator/G2: U4.12 (g3), U4.22 (g2), U4.28 (g1), U5.10 (G), U6.17 (SEG_G), U7.5 (g)
/Indicator/SPI1_MOSI: TP1.1, U3.1 (DIN); also elsewhere on the board
/Indicator/SPI1_NSS: TP2.1, U3.12 (LOAD), U6.12 (LOAD); also elsewhere on the board
/Indicator/SPI1_SCK: TP3.1, U3.13 (CLK), U6.13 (CLK); also elsewhere on the board
/Indicator/WEST_SKIP_LED: R4.2; also elsewhere on the board
GNDREF: C43.2, C44.2, Q1.2 (E), Q2.2 (E), U3.4 (GND), U3.9 (GND), U6.4 (GND), U6.9 (GND); also elsewhere on the board
unnamed: D1.1 (K), Q1.3 (C)
unnamed: D1.2 (A), R1.2
unnamed: D2.1 (K), Q2.3 (C)
unnamed: D2.2 (A), R2.2
unnamed: Q1.1 (B), R4.1
unnamed: Q2.1 (B), R5.1
unnamed: R3.2, R6.1
unnamed: R6.2, U3.18 (ISET)
unnamed: R7.2, R8.1
unnamed: R8.2, U6.18 (ISET)
unnamed: TP4.1, U3.24 (DOUT), U6.1 (DIN)

Notes on the sheet:
"Вес"
"Дата"
"Время"
"EAST"
PG10
PG11
"WEST"
PD7
"No Смены"
"No Цикла"
PF3
PF2

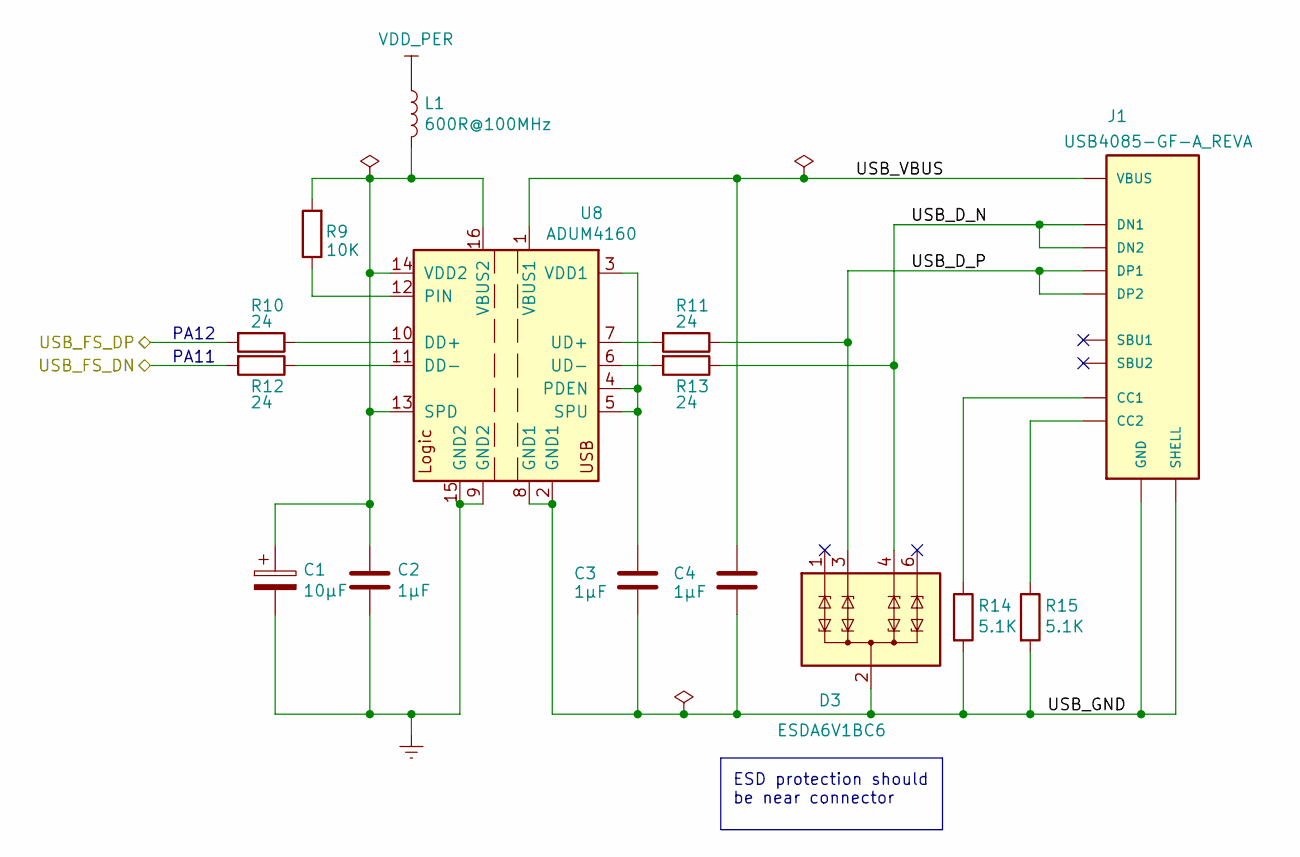
[picture p8: schematic U_USB.kicad_sch, ШВУ]

Parts:
C1: 10µF; CP_EIA-3216-10_Kemet-I
C2, C3, C4: 1µF; C_0603_1608Metric_Pad1.08x0.95mm_HandSolder
D3: ESDA6V1BC6; SOT-23-6
J1: USB4085-GF-A_REVA; GCT_USB4085-GF-A_REVA; PARTREV A2
L1: 600R@100MHz; L_0805_2012Metric_Pad1.15x1.40mm_HandSolder
R9: 10K; R_0805_2012Metric_Pad1.20x1.40mm_HandSolder
R10, R11, R12, R13: 24; R_0805_2012Metric_Pad1.20x1.40mm_HandSolder
R14, R15: 5.1K; R_0805_2012Metric_Pad1.20x1.40mm_HandSolder
U8: ADUM4160; SOIC-16W_7.5x10.3mm_P1.27mm

Connections:
/Microcontroller/USB_FS_DN: R12.2; also elsewhere on the board
/Microcontroller/USB_FS_DP: R10.2; also elsewhere on the board
/USB/USB_D_N: D3.4 (TVS3), J1.A7 (DN1), J1.B7 (DN2), R13.1
/USB/USB_D_P: D3.3 (TVS2), J1.A6 (DP1), J1.B6 (DP2), R11.1
/USB/USB_GND: C3.2, C4.2, D3.2 (COM), D3.5 (COM), J1.A1 (GND), J1.A12 (GND), J1.B1 (GND), J1.B12 (GND), J1.P1 (SHELL), J1.P2 (SHELL), J1.P3 (SHELL), J1.P4 (SHELL), R14.2, R15.2, U8.2 (GND1), U8.8 (GND1)
/USB/USB_VBUS: C4.1, J1.A4 (VBUS), J1.A9 (VBUS), J1.B4 (VBUS), J1.B9 (VBUS), U8.1 (VBUS1)
GNDREF: C1.2, C2.2, U8.9 (GND2), U8.15 (GND2); also elsewhere on the board
unnamed: C1.1, C2.1, L1.2, R9.2, U8.13 (SPD), U8.14 (VDD2), U8.16 (VBUS2)
unnamed: C3.1, U8.3 (VDD1), U8.4 (PDEN), U8.5 (SPU)
unnamed: J1.A5 (CC1), R14.1
unnamed: J1.B5 (CC2), R15.1
unnamed: R9.1, U8.12 (PIN)
unnamed: R10.1, U8.10 (DD+)
unnamed: R11.2, U8.7 (UD+)
unnamed: R12.1, U8.11 (DD-)
unnamed: R13.2, U8.6 (UD-)
VDD_PER: L1.1; also elsewhere on the board

Notes on the sheet:
PA11
PA12
ESD protection should be near connector
