SVIELCOM/MWE_Schema_and_PCB/Schema_and_PCB.kicad_pcb

## KiCad design Schema_and_PCB.kicad_pcb (continued)

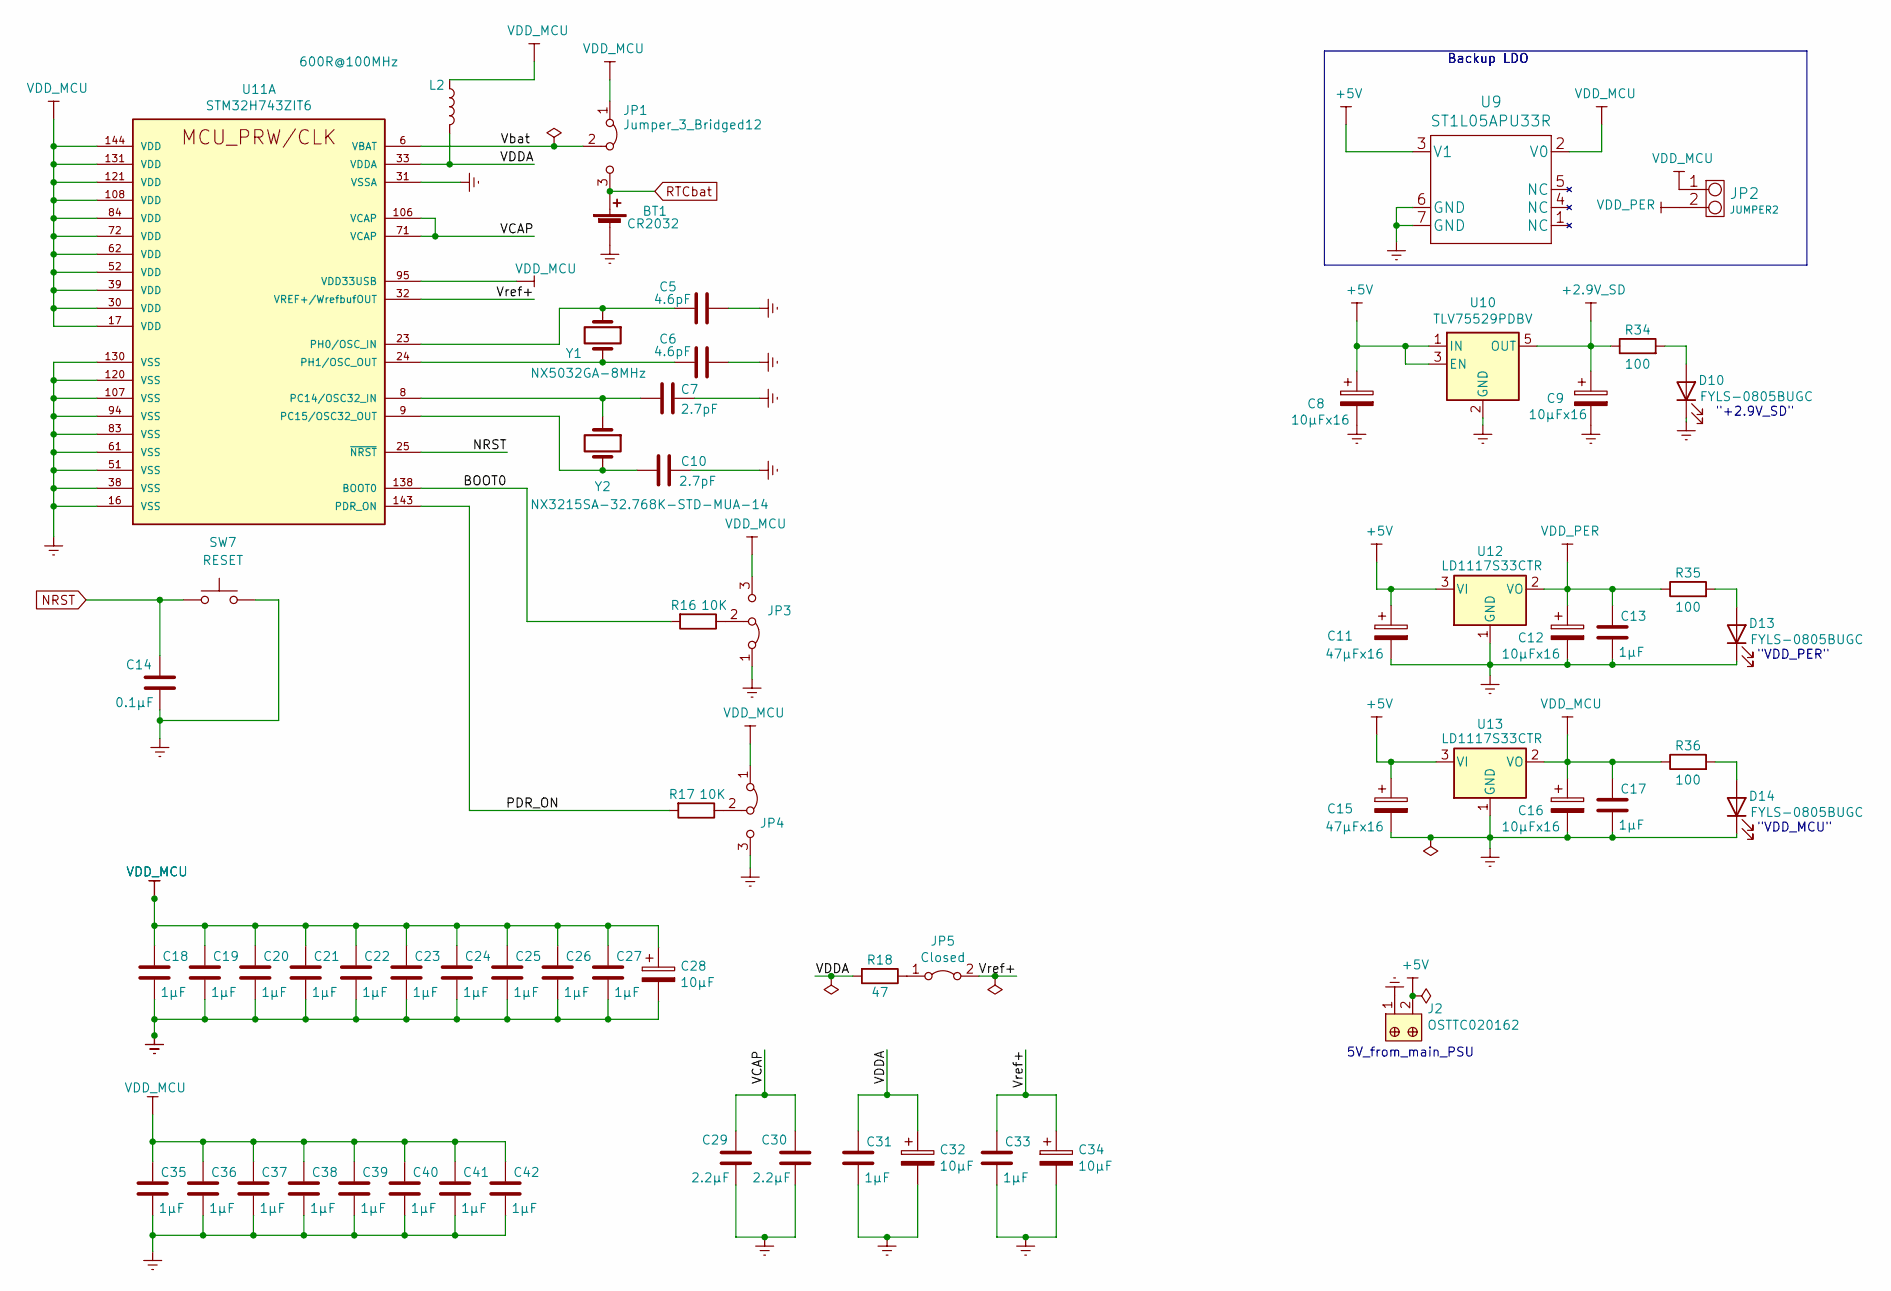
[picture p9: schematic MCU_Power_supply_clocking.kicad_sch, ШВУ]

Parts:
BT1: CR2032; BAT_BS-7
C5, C6: 4.6pF; C_0603_1608Metric_Pad1.08x0.95mm_HandSolder
C7, C10: 2.7pF; C_0603_1608Metric_Pad1.08x0.95mm_HandSolder
C8, C9, C12, C16: 10µFx16; CP_EIA-3216-10_Kemet-I
C11, C15: 47µFx16; CP_EIA-7343-31_Kemet-D_Pad2.25x2.55mm_HandSolder
C13, C17, C18, C19, C20, C21, C22, C23, C24, C25, C26, C27, C31, C33, C35, C36, C37, C38, C39, C40, C41, C42: 1µF; C_0603_1608Metric_Pad1.08x0.95mm_HandSolder
C14: 0.1µF; C_0603_1608Metric_Pad1.08x0.95mm_HandSolder
C28, C32, C34: 10µF; CP_EIA-3216-10_Kemet-I
C29, C30: 2.2µF; C_0603_1608Metric_Pad1.08x0.95mm_HandSolder
D10, D13, D14: FYLS-0805BUGC; LED_0805_2012Metric
J2: OSTTC020162; Term_Block_1x2_P5mm; MPN OSTTC020162; Digi-Key_PN ED2600-ND
JP1, JP4: Jumper_3_Bridged12; SolderJumper-3_P1.3mm_Open_RoundedPad1.0x1.5mm_NumberLabels
JP2: JUMPER2; PinHeader_1x02_P2.54mm_Vertical
JP3: BOOT0; PinHeader_1x03_P2.54mm_Horizontal
JP5: Closed; SolderJumper-2_P1.3mm_Open_RoundedPad1.0x1.5mm
L2: 600R@100MHz; L_0805_2012Metric_Pad1.15x1.40mm_HandSolder
R16, R17: 10K; R_0805_2012Metric_Pad1.20x1.40mm_HandSolder
R18: 47; R_0805_2012Metric_Pad1.20x1.40mm_HandSolder
R34, R35, R36: 100; R_0805_2012Metric
SW7: RESET; SW_PUSH_6mm
U9: ST1L05APU33R
U10: TLV75529PDBV; SOT-23-5
U11: STM32H743ZIT6; QFP50P2200X2200X160-144N; PARTREV 7
U12, U13: LD1117S33CTR; SOT-223-3_TabPin2
Y1: NX5032GA-8MHz; Crystal_SMD_5032-2Pin_5.0x3.2mm
Y2: NX3215SA-32.768K-STD-MUA-14; Crystal_SMD_MicroCrystal_CC7V-T1A-2Pin_3.2x1.5mm_HandSolder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

Connections:
+2,9V: C9.1, R34.1, U10.5 (OUT); also elsewhere on the board
/MCU_Power_supply_clocking/BOOT0: R16.2, U11.138 (BOOT0)
/MCU_Power_supply_clocking/PDR_ON: R17.2, U11.143 (PDR_ON)
/MCU_Power_supply_clocking/VCAP: C29.2, C30.2, U11.71 (VCAP), U11.106 (VCAP)
/MCU_Power_supply_clocking/VDDA: C31.1, C32.1, L2.2, R18.2, U11.33 (VDDA)
/MCU_Power_supply_clocking/Vbat: JP1.2 (C), U11.6 (VBAT)
/MCU_Power_supply_clocking/Vref+: C33.1, C34.1, JP5.2 (B), U11.32 (VREF+/WrefbufOUT)
GNDREF: BT1.2 (-), C5.1, C6.1, C7.1, C8.2, C9.2, C10.1, C11.2, C12.2, C13.2, C14.1, C15.2, C16.2, C17.2, C18.2, C19.2, C20.2, C21.2, C22.2, C23.2, C24.2, C25.2, C26.2, C27.2, C28.2, C29.1, C30.1, C31.2, C32.2, C33.2, C34.2, C35.2, C36.2, C37.2, C38.2, C39.2, C40.2, C41.2, C42.2, D10.1 (K), D13.1 (K), D14.1 (K), J2.1, JP3.1 (A), JP4.3 (B), SW7.2, U9.6 (GND), U9.7 (GND), U10.2 (GND), U11.16 (VSS), U11.31 (VSSA), U11.38 (VSS), U11.51 (VSS), U11.61 (VSS), U11.83 (VSS), U11.94 (VSS), U11.107 (VSS), U11.120 (VSS), U11.130 (VSS), U12.1 (GND), U13.1 (GND); also elsewhere on the board
NRST: C14.2, SW7.1, U11.25 (~NRST); also elsewhere on the board
unnamed: C5.2, U11.23 (PH0/OSC_IN), Y1.1
unnamed: C6.2, U11.24 (PH1/OSC_OUT), Y1.2
unnamed: C7.2, U11.8 (PC14/OSC32_IN), Y2.1
unnamed: C10.2, U11.9 (PC15/OSC32_OUT), Y2.2
unnamed: D10.2 (A), R34.2
unnamed: D13.2 (A), R35.2
unnamed: D14.2 (A), R36.2
unnamed: JP3.2 (C), R16.1
unnamed: JP4.2 (C), R17.1
unnamed: JP5.1 (A), R18.1
RTCbat: BT1.1 (+), JP1.3 (B); also elsewhere on the board
VDD_MCU: C16.1, C17.1, C18.1, C19.1, C20.1, C21.1, C22.1, C23.1, C24.1, C25.1, C26.1, C27.1, C28.1, C35.1, C36.1, C37.1, C38.1, C39.1, C40.1, C41.1, C42.1, JP1.1 (A), JP2.1, JP3.3 (B), JP4.1 (A), L2.1, R36.1, U9.2 (V0), U11.17 (VDD), U11.30 (VDD), U11.39 (VDD), U11.52 (VDD), U11.62 (VDD), U11.72 (VDD), U11.84 (VDD), U11.95 (VDD33USB), U11.108 (VDD), U11.121 (VDD), U11.131 (VDD), U11.144 (VDD), U13.2 (VO); also elsewhere on the board
VDD_PER: C12.1, C13.1, JP2.2, R35.1, U12.2 (VO); also elsewhere on the board

Notes on the sheet:
Backup LDO
5V_from_main_PSU
"VDD_PER"
"+2.9V_SD"
"VDD_MCU"

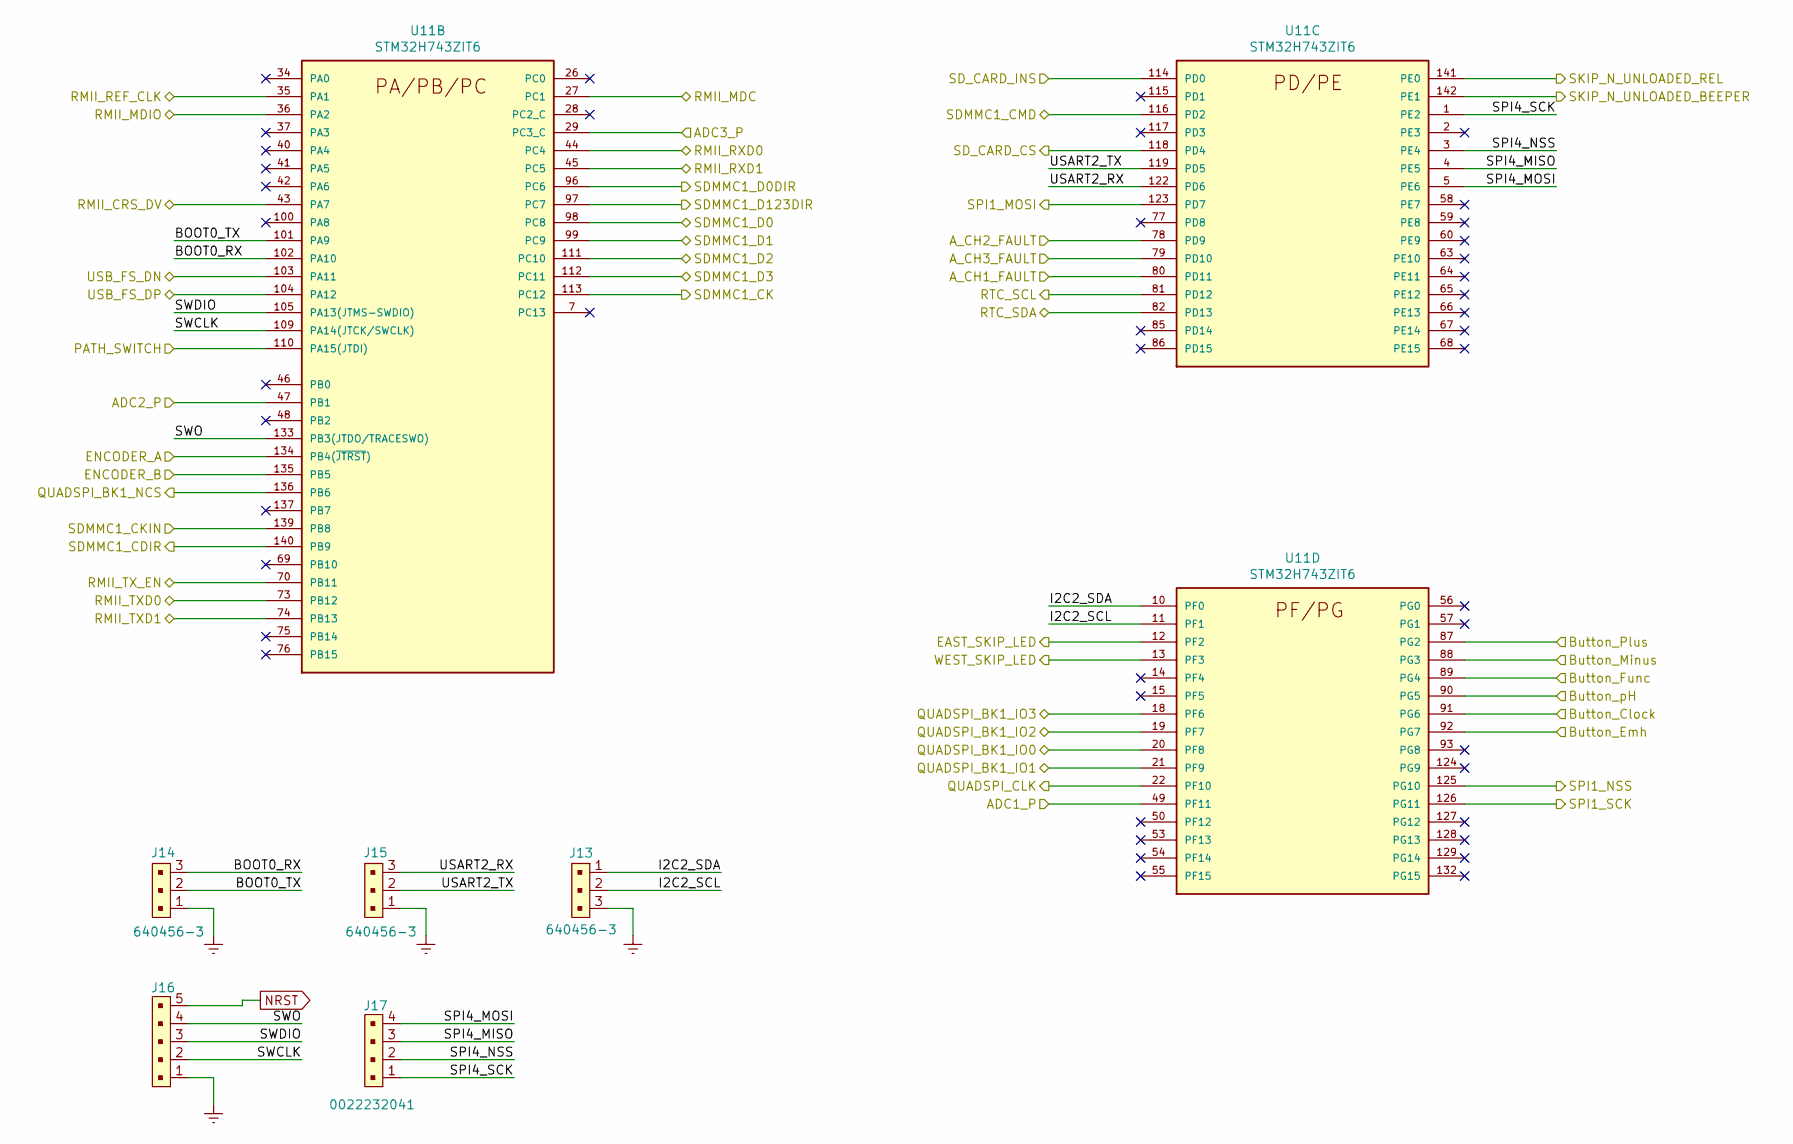
[picture p10: schematic Microcontroller.kicad_sch, ШВУ]

Parts:
J13, J14, J15: 640456-3; PinHeader_1x03_P2.54mm_Vertical; MPN 640456-3; Digi-Key_PN A19470-ND
J16: B5B-XH-A_LF__SN_; PinHeader_1x05_P2.54mm_Vertical; MPN B5B-XH-A(LF)(SN); Digi-Key_PN 455-2270-ND
J17: 0022232041; PinHeader_1x04_P2.54mm_Vertical; MPN 0022232041; Digi-Key_PN WM4202-ND
U11: STM32H743ZIT6; QFP50P2200X2200X160-144N; PARTREV 7

Connections:
/Buttons/Button_Clock: U11.91 (PG6); also elsewhere on the board
/Buttons/Button_Emh: U11.92 (PG7); also elsewhere on the board
/Buttons/Button_Func: U11.89 (PG4); also elsewhere on the board
/Buttons/Button_Minus: U11.88 (PG3); also elsewhere on the board
/Buttons/Button_Plus: U11.87 (PG2); also elsewhere on the board
/Buttons/Button_pH: U11.90 (PG5); also elsewhere on the board
/Digital_IO_analog_Inputs/ADC1_P: U11.49 (PF11); also elsewhere on the board
/Digital_IO_analog_Inputs/ADC2_P: U11.47 (PB1); also elsewhere on the board
/Digital_IO_analog_Inputs/ADC3_P: U11.29 (PC3_C); also elsewhere on the board
/Digital_IO_analog_Inputs/A_CH1_FAULT: U11.77 (PD8); also elsewhere on the board
/Digital_IO_analog_Inputs/A_CH2_FAULT: U11.75 (PB14); also elsewhere on the board
/Digital_IO_analog_Inputs/A_CH3_FAULT: U11.76 (PB15); also elsewhere on the board
/Digital_IO_analog_Inputs/ENCODER_A: U11.134 (PB4(~JTRST)); also elsewhere on the board
/Digital_IO_analog_Inputs/ENCODER_B: U11.135 (PB5); also elsewhere on the board
/Digital_IO_analog_Inputs/LEVEL_SWITCH: U11.110 (PA15(JTDI)); also elsewhere on the board
/Digital_IO_analog_Inputs/SKIP_N_UNLOADED_BEEPER: U11.142 (PE1); also elsewhere on the board
/Digital_IO_analog_Inputs/SKIP_N_UNLOADED_REL: U11.141 (PE0); also elsewhere on the board
/Indicator/EAST_SKIP_LED: U11.12 (PF2); also elsewhere on the board
/Indicator/SPI1_MOSI: U11.123 (PD7); also elsewhere on the board
/Indicator/SPI1_NSS: U11.125 (PG10); also elsewhere on the board
/Indicator/SPI1_SCK: U11.126 (PG11); also elsewhere on the board
/Indicator/WEST_SKIP_LED: U11.13 (PF3); also elsewhere on the board
/LAN/RMII_CRS_DV: U11.43 (PA7); also elsewhere on the board
/LAN/RMII_MDC: U11.27 (PC1); also elsewhere on the board
/LAN/RMII_MDIO: U11.36 (PA2); also elsewhere on the board
/LAN/RMII_REF_CLK: U11.35 (PA1); also elsewhere on the board
/LAN/RMII_RXD0: U11.44 (PC4); also elsewhere on the board
/LAN/RMII_RXD1: U11.45 (PC5); also elsewhere on the board
/LAN/RMII_TXD0: U11.73 (PB12); also elsewhere on the board
/LAN/RMII_TXD1: U11.74 (PB13); also elsewhere on the board
/LAN/RMII_TX_EN: U11.70 (PB11); also elsewhere on the board
/Microcontroller/BOOT0_RX: J14.3, U11.102 (PA10)
/Microcontroller/BOOT0_TX: J14.2, U11.101 (PA9)
/Microcontroller/I2C2_SCL: J13.2, U11.11 (PF1)
/Microcontroller/I2C2_SDA: J13.1, U11.10 (PF0)
/Microcontroller/QUADSPI_BK1_NCS: U11.136 (PB6); also elsewhere on the board
/Microcontroller/QUADSPI_CLK: U11.22 (PF10); also elsewhere on the board
/Microcontroller/RTC_SCL: U11.81 (PD12); also elsewhere on the board
/Microcontroller/RTC_SDA: U11.82 (PD13); also elsewhere on the board
/Microcontroller/SDMMC1_CDIR: U11.140 (PB9); also elsewhere on the board
/Microcontroller/SDMMC1_CK: U11.113 (PC12); also elsewhere on the board
/Microcontroller/SDMMC1_CKIN: U11.139 (PB8); also elsewhere on the board
/Microcontroller/SDMMC1_CMD: U11.116 (PD2); also elsewhere on the board
/Microcontroller/SDMMC1_D0: U11.98 (PC8); also elsewhere on the board
/Microcontroller/SDMMC1_D0DIR: U11.96 (PC6); also elsewhere on the board
/Microcontroller/SDMMC1_D1: U11.99 (PC9); also elsewhere on the board
/Microcontroller/SDMMC1_D2: U11.111 (PC10); also elsewhere on the board
/Microcontroller/SDMMC1_D3: U11.112 (PC11); also elsewhere on the board
/Microcontroller/SDMMC1_D123DIR: U11.97 (PC7); also elsewhere on the board
/Microcontroller/SD_CARD_CS: U11.118 (PD4); also elsewhere on the board
/Microcontroller/SD_CARD_INS: U11.117 (PD3); also elsewhere on the board
/Microcontroller/SPI4_MISO: J17.3, U11.4 (PE5)
/Microcontroller/SPI4_MOSI: J17.4, U11.5 (PE6)
/Microcontroller/SPI4_NSS: J17.2, U11.3 (PE4)
/Microcontroller/SPI4_SCK: J17.1, U11.1 (PE2)
/Microcontroller/SWCLK: J16.2, U11.109 (PA14(JTCK/SWCLK))
/Microcontroller/SWDIO: J16.3, U11.105 (PA13(JTMS-SWDIO))
/Microcontroller/SWO: J16.4, U11.133 (PB3(JTDO/TRACESWO))
/Microcontroller/USART2_RX: J15.3, U11.122 (PD6)
/Microcontroller/USART2_TX: J15.2, U11.119 (PD5)
/Microcontroller/USB_FS_DN: U11.103 (PA11); also elsewhere on the board
/Microcontroller/USB_FS_DP: U11.104 (PA12); also elsewhere on the board
/Storage_and_memory/QUADPSI_BK1_IO0: U11.20 (PF8); also elsewhere on the board
/Storage_and_memory/QUADPSI_BK1_IO1: U11.21 (PF9); also elsewhere on the board
/Storage_and_memory/QUADPSI_BK1_IO2: U11.19 (PF7); also elsewhere on the board
/Storage_and_memory/QUADPSI_BK1_IO3: U11.18 (PF6); also elsewhere on the board
GNDREF: J13.3, J14.1, J15.1, J16.1; also elsewhere on the board
NRST: J16.5; also elsewhere on the board

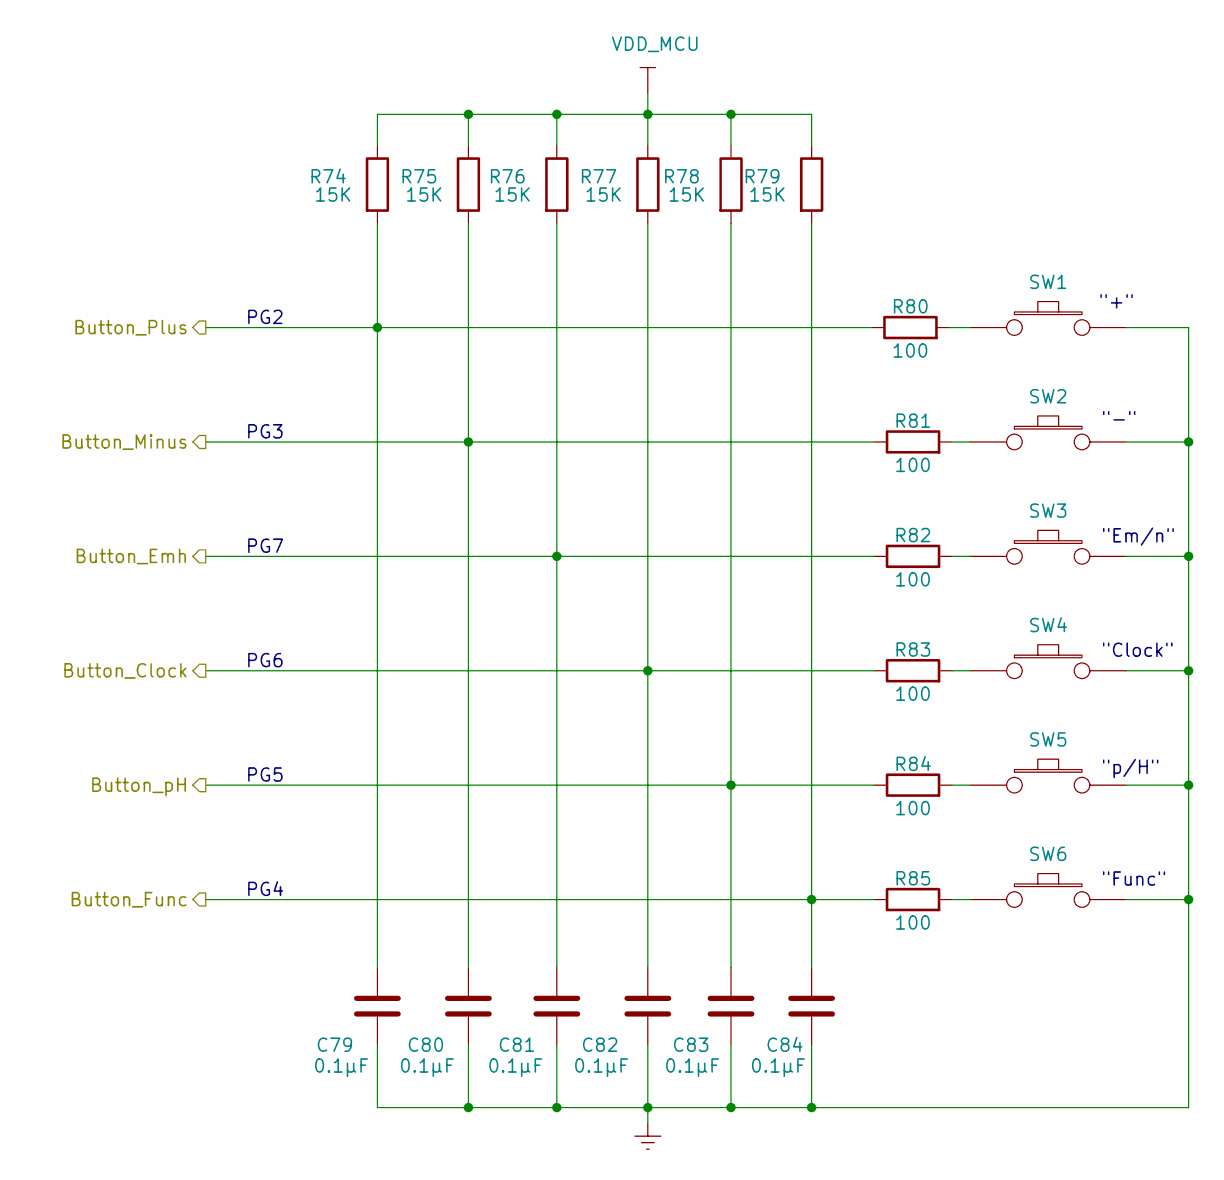
[picture p11: schematic Buttons.kicad_sch, ШВУ]

Parts:
C79, C80, C81, C82, C83, C84: 0.1µF; C_0603_1608Metric_Pad1.08x0.95mm_HandSolder
R74, R75, R76, R77, R78, R79: 15K; R_0805_2012Metric_Pad1.20x1.40mm_HandSolder
R80, R81, R82, R83, R84, R85: 100; R_0805_2012Metric_Pad1.20x1.40mm_HandSolder
SW1, SW2, SW3, SW4, SW5, SW6: SW_PUSHBUTTON; PinHeader_1x2_P2.54mm

Connections:
/Buttons/Button_Clock: C82.1, R77.2, R83.1; also elsewhere on the board
/Buttons/Button_Emh: C81.1, R76.2, R82.1; also elsewhere on the board
/Buttons/Button_Func: C84.1, R79.2, R85.1; also elsewhere on the board
/Buttons/Button_Minus: C80.1, R75.2, R81.1; also elsewhere on the board
/Buttons/Button_Plus: C79.1, R74.2, R80.1; also elsewhere on the board
/Buttons/Button_pH: C83.1, R78.2, R84.1; also elsewhere on the board
GNDREF: C79.2, C80.2, C81.2, C82.2, C83.2, C84.2, SW1.2, SW2.2, SW3.2, SW4.2, SW5.2, SW6.2; also elsewhere on the board
unnamed: R80.2, SW1.1
unnamed: R81.2, SW2.1
unnamed: R82.2, SW3.1
unnamed: R83.2, SW4.1
unnamed: R84.2, SW5.1
unnamed: R85.2, SW6.1
VDD_MCU: R74.1, R75.1, R76.1, R77.1, R78.1, R79.1; also elsewhere on the board

Notes on the sheet:
"Func"
PG4
"Em/n"
PG7
"+"
"p/H"
PG6
PG3
"Clock"
PG5
"-"
PG2

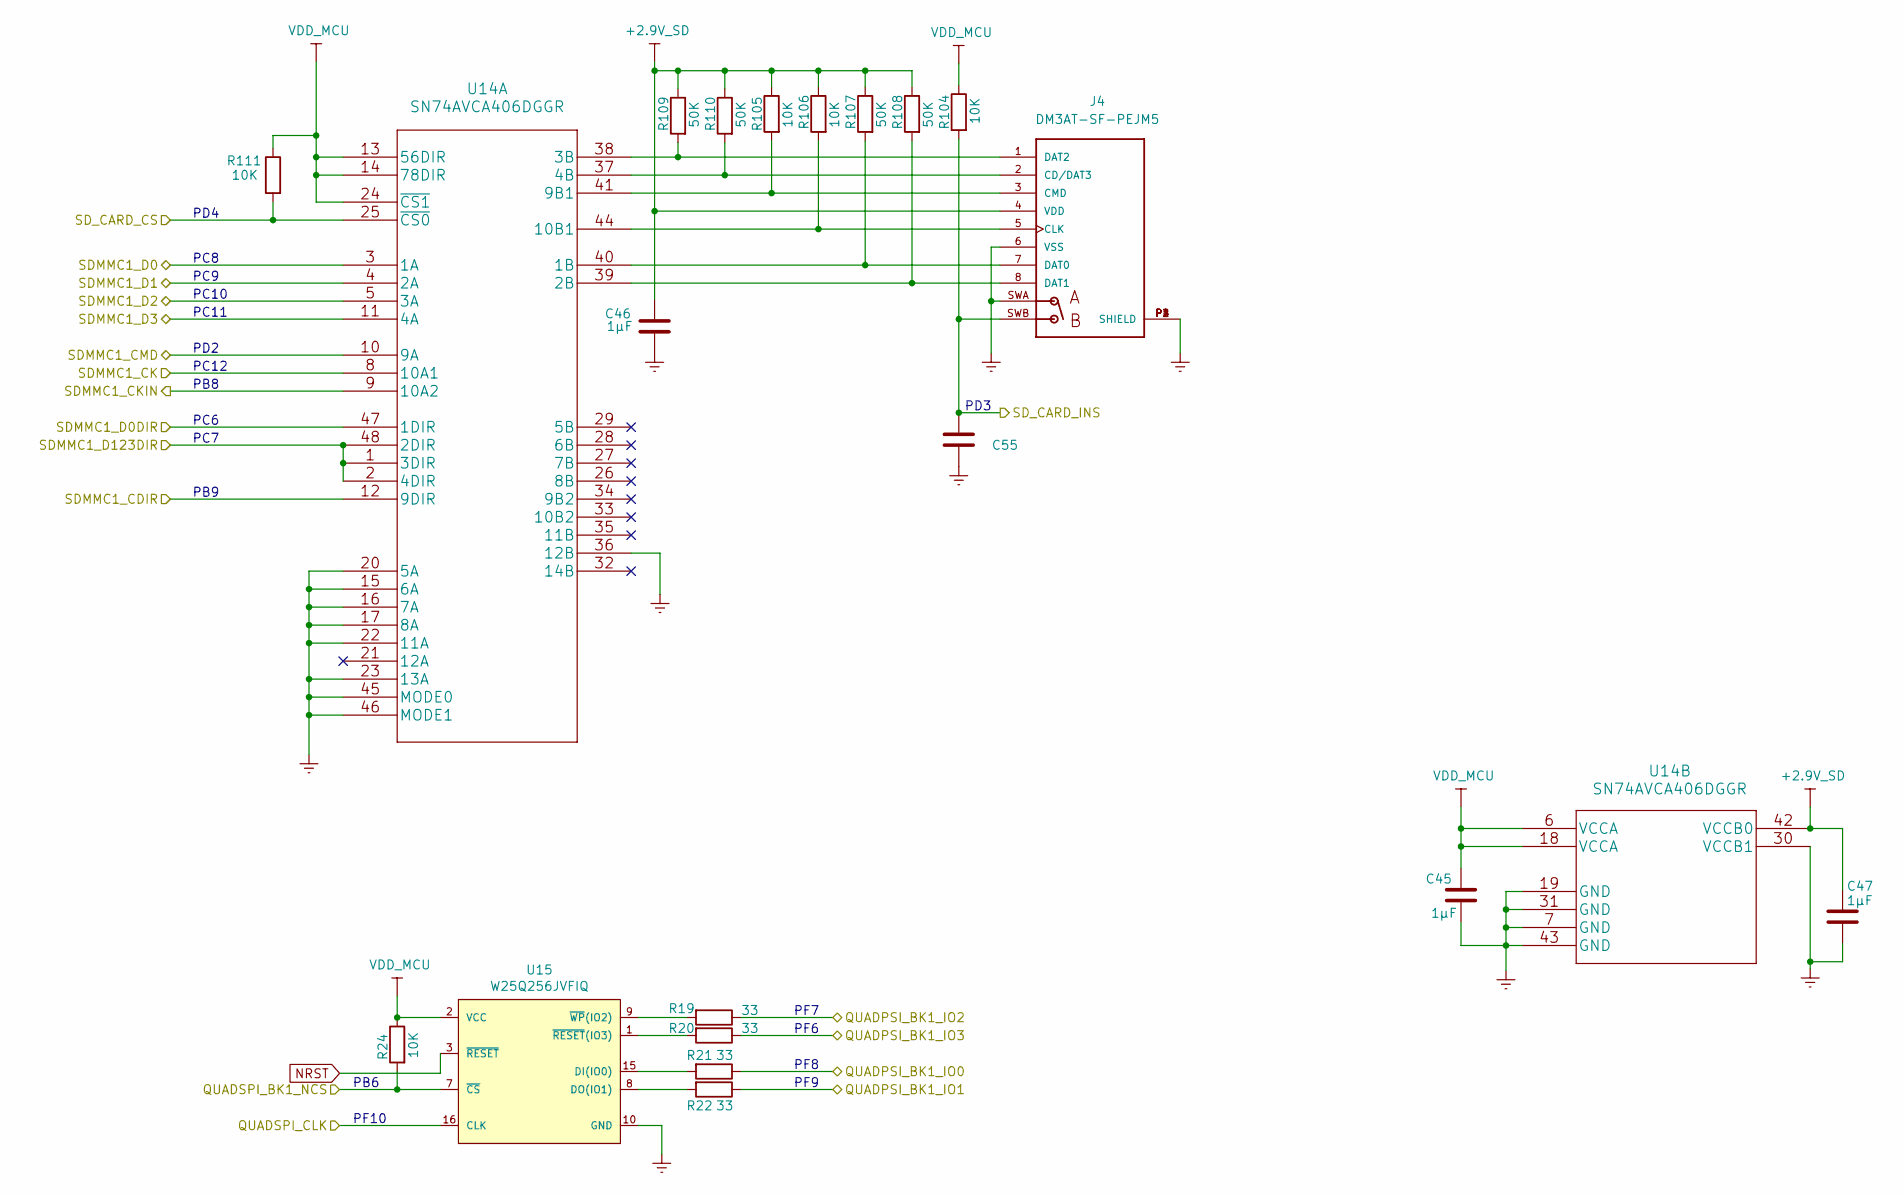
[picture p12: schematic Storage_and_memory.kicad_sch, ШВУ]

Parts:
C45, C46, C47: 1µF; C_0603_1608Metric_Pad1.08x0.95mm_HandSolder
C55: (no value)
J4: DM3AT-SF-PEJM5; HRS_DM3AT-SF-PEJM5
R19, R20, R21, R22: 33; R_0805_2012Metric
R24: 10K; R_0805_2012Metric_Pad1.20x1.40mm_HandSolder
R104, R105, R106, R111: 10K; R_0805_2012Metric
R107, R108, R109, R110: 50K; R_0805_2012Metric
U14: SN74AVCA406DGGR
U15: W25Q256JVFIQ; SOIC-16W_7.5x10.3mm_P1.27mm; digikey description IC FLASH 256MBIT 104MHZ 16WSOIC

Connections:
+2,9V: C46.1, C47.1, J4.4 (VDD), R105.1, R106.1, R107.1, R108.1, R109.1, R110.1, U14.42 (VCCB0); also elsewhere on the board
/Microcontroller/QUADSPI_BK1_NCS: R24.2, U15.7 (~CS); also elsewhere on the board
/Microcontroller/QUADSPI_CLK: U15.16 (CLK); also elsewhere on the board
/Microcontroller/SDMMC1_CDIR: U14.12 (9DIR); also elsewhere on the board
/Microcontroller/SDMMC1_CK: U14.8 (10A1); also elsewhere on the board
/Microcontroller/SDMMC1_CKIN: U14.9 (10A2); also elsewhere on the board
/Microcontroller/SDMMC1_CMD: U14.10 (9A); also elsewhere on the board
/Microcontroller/SDMMC1_D0: U14.3 (1A); also elsewhere on the board
/Microcontroller/SDMMC1_D0DIR: U14.47 (1DIR); also elsewhere on the board
/Microcontroller/SDMMC1_D1: U14.4 (2A); also elsewhere on the board
/Microcontroller/SDMMC1_D2: U14.5 (3A); also elsewhere on the board
/Microcontroller/SDMMC1_D3: U14.11 (4A); also elsewhere on the board
/Microcontroller/SDMMC1_D123DIR: U14.1 (3DIR), U14.2 (4DIR), U14.48 (2DIR); also elsewhere on the board
/Microcontroller/SD_CARD_CS: R111.2, U14.25 (~CS0); also elsewhere on the board
/Microcontroller/SD_CARD_INS: C55.1, J4.SWB, R104.2; also elsewhere on the board
/Storage_and_memory/QUADPSI_BK1_IO0: R21.1; also elsewhere on the board
/Storage_and_memory/QUADPSI_BK1_IO1: R22.1; also elsewhere on the board
/Storage_and_memory/QUADPSI_BK1_IO2: R19.1; also elsewhere on the board
/Storage_and_memory/QUADPSI_BK1_IO3: R20.1; also elsewhere on the board
GNDREF: C45.2, C46.2, C47.2, C55.2, J4.6 (VSS), J4.P1 (SHIELD), J4.P2 (SHIELD), J4.P3 (SHIELD), J4.P4 (SHIELD), J4.SWA, U14.7 (GND), U14.15 (6A), U14.16 (7A), U14.17 (8A), U14.19 (GND), U14.20 (5A), U14.22 (11A), U14.23 (13A), U14.30 (VCCB1), U14.31 (GND), U14.36 (12B), U14.43 (GND), U14.45 (MODE0), U14.46 (MODE1), U15.10 (GND); also elsewhere on the board
NRST: U15.3 (~RESET); also elsewhere on the board
unnamed: J4.1 (DAT2), R109.2, U14.38 (3B)
unnamed: J4.2 (CD/DAT3), R110.2, U14.37 (4B)
unnamed: J4.3 (CMD), R105.2, U14.41 (9B1)
unnamed: J4.5 (CLK), R106.2, U14.44 (10B1)
unnamed: J4.7 (DAT0), R107.2, U14.40 (1B)
unnamed: J4.8 (DAT1), R108.2, U14.39 (2B)
unnamed: R19.2, U15.9 (~WP(IO2))
unnamed: R20.2, U15.1 (~RESET(IO3))
unnamed: R21.2, U15.15 (DI(IO0))
unnamed: R22.2, U15.8 (DO(IO1))
VDD_MCU: C45.1, R24.1, R104.1, R111.1, U14.6 (VCCA), U14.13 (56DIR), U14.14 (78DIR), U14.18 (VCCA), U14.24 (~CS1), U15.2 (VCC); also elsewhere on the board

Notes on the sheet:
PF10
PD3
PC8
PB6
PC9
PF7
PF8
PF9
PD4
PC12
PF6
PD2
PB9
PC11
PB8
PC7
PC6
PC10

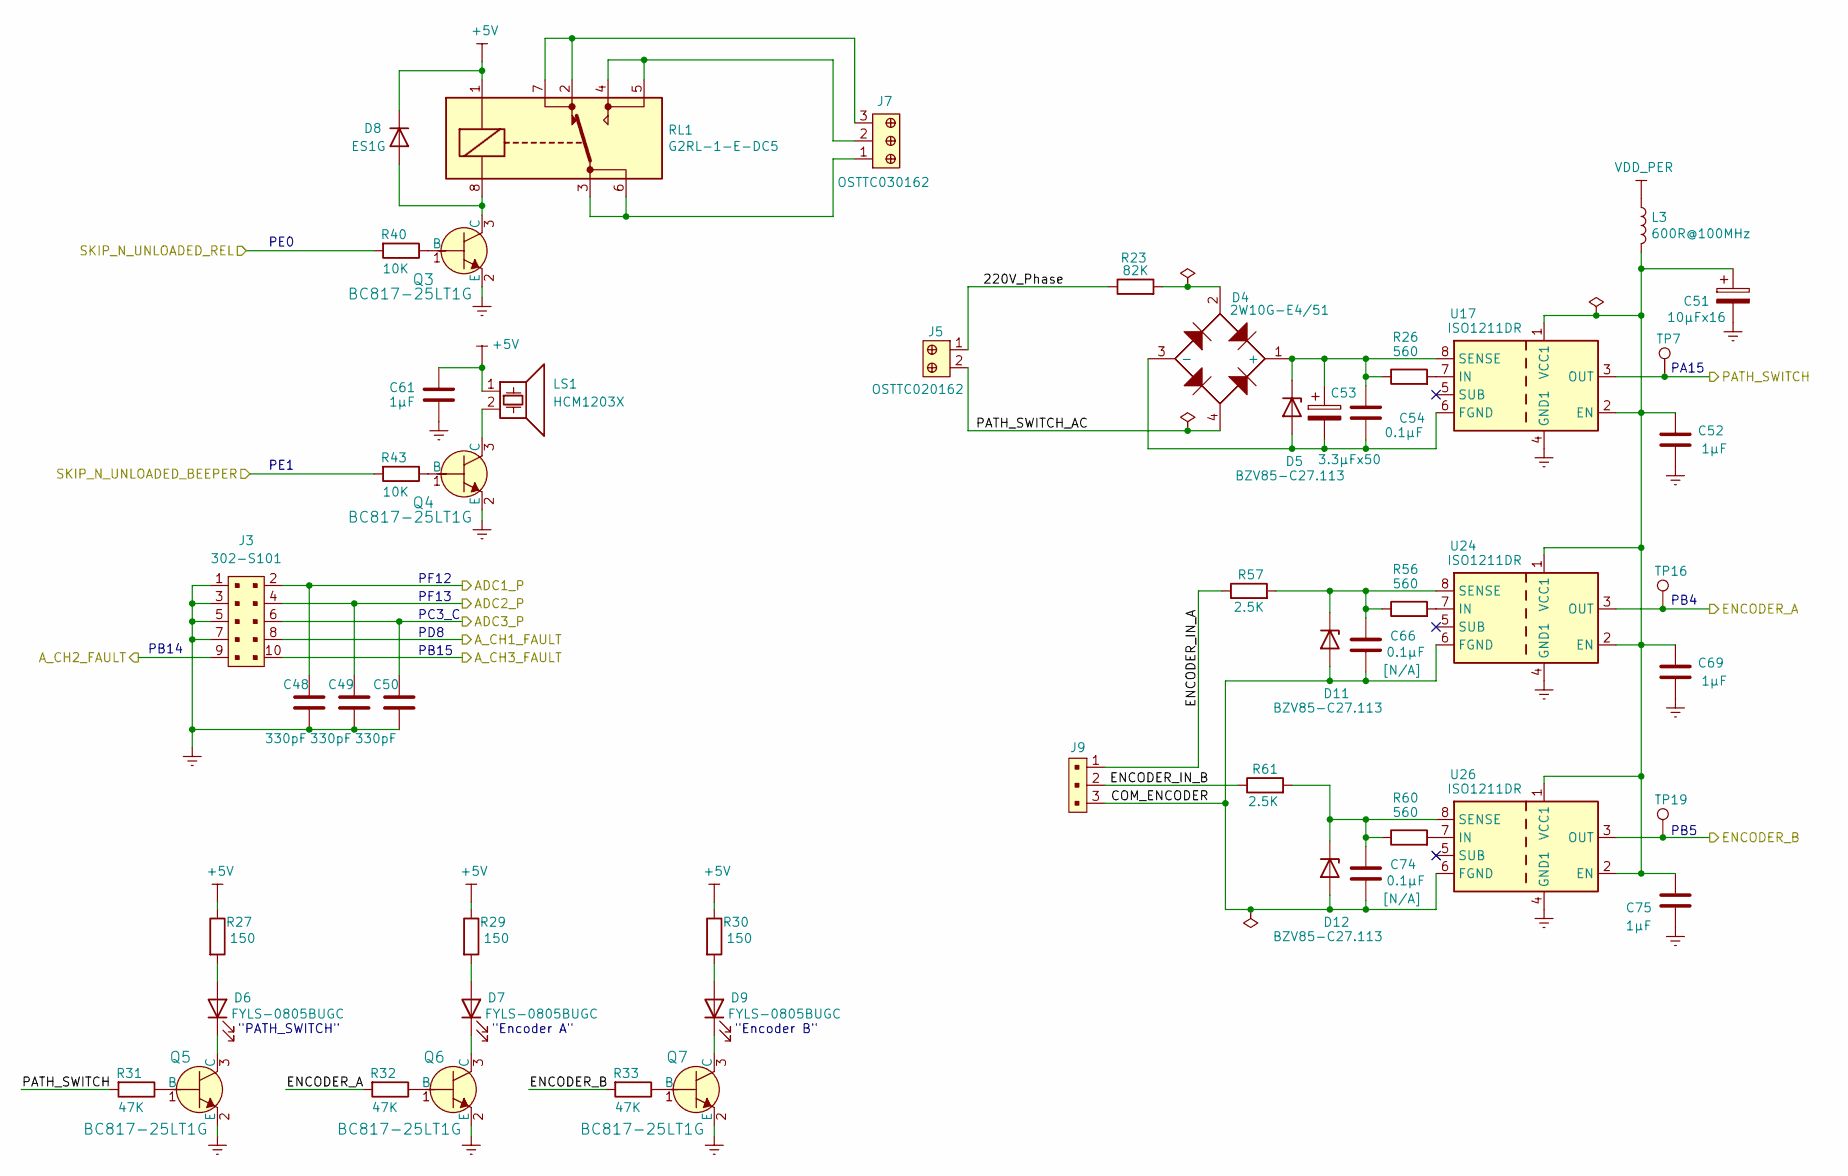
[picture p13: schematic Digital_IO_analog_Inputs.kicad_sch, ШВУ]

Parts:
C48, C49, C50: 330pF; C_0603_1608Metric_Pad1.08x0.95mm_HandSolder
C51: 10µFx16; CP_EIA-3216-10_Kemet-I
C52, C61, C69, C75: 1µF; C_0603_1608Metric_Pad1.08x0.95mm_HandSolder
C53: 3.3µFx50; CP_EIA-6032-15_Kemet-U
C54, C66, C74: 0.1µF; C_0603_1608Metric_Pad1.08x0.95mm_HandSolder
D4: 2W10G-E4/51; Diode_Bridge_Round_D9.8mm
D5, D11, D12: BZV85-C27.113; D_DO-41_SOD81_P10.16mm_Horizontal
D6, D7, D9: FYLS-0805BUGC; LED_0805_2012Metric
D8: ES1G; D_SMA_Handsoldering
J3: 302-S101; PinHeader_2x5_P2.54mm_Drill1.2mm; MPN 302-S101; Digi-Key_PN ED1543-ND
J5: OSTTC020162; Term_Block_1x2_P5mm; MPN OSTTC020162; Digi-Key_PN ED2600-ND
J7: OSTTC030162; Term_Block_1x3_P5mm; MPN OSTTC030162; Digi-Key_PN ED2601-ND
J9: 0022232031; PinHeader_1x3_P2.54mm_Drill1.02mm; MPN 0022232031; Digi-Key_PN WM4201-ND
L3: 600R@100MHz; L_0805_2012Metric_Pad1.15x1.40mm_HandSolder
LS1: HCM1203X; Buzzer_12x9.5RM7.6
Q3, Q4, Q5, Q6, Q7: BC817-25LT1G; SOT-23-3; MPN BC817-25LT1G; Digi-Key_PN BC817-25LT1GOSCT-ND
R23: 82K; R_Axial_DIN0207_L6.3mm_D2.5mm_P10.16mm_Horizontal
R26, R56, R60: 560; R_0805_2012Metric_Pad1.20x1.40mm_HandSolder
R27, R29, R30: 150; R_0805_2012Metric_Pad1.20x1.40mm_HandSolder
R31, R32, R33: 47K; R_0805_2012Metric_Pad1.20x1.40mm_HandSolder
R40, R43: 10K; R_0805_2012Metric_Pad1.20x1.40mm_HandSolder
R57, R61: 2.5K; R_Axial_DIN0207_L6.3mm_D2.5mm_P10.16mm_Horizontal
RL1: G2RL-1-E-DC5; Relay_DPDT_Omron_G2RL
TP7, TP16, TP19: TestPoint; TestPoint_Pad_D1.5mm
U17, U24, U26: ISO1211DR; SOIC-8_3.9x4.9mm_P1.27mm

Connections:
/Digital_IO_analog_Inputs/220V_Phase: J5.1, R23.1
/Digital_IO_analog_Inputs/ADC1_P: C48.1, J3.2; also elsewhere on the board
/Digital_IO_analog_Inputs/ADC2_P: C49.1, J3.4; also elsewhere on the board
/Digital_IO_analog_Inputs/ADC3_P: C50.1, J3.6; also elsewhere on the board
/Digital_IO_analog_Inputs/A_CH1_FAULT: J3.8; also elsewhere on the board
/Digital_IO_analog_Inputs/A_CH2_FAULT: J3.9; also elsewhere on the board
/Digital_IO_analog_Inputs/A_CH3_FAULT: J3.10; also elsewhere on the board
/Digital_IO_analog_Inputs/ENCODER_A: TP16.1, U24.3 (OUT); also elsewhere on the board
/Digital_IO_analog_Inputs/ENCODER_B: TP19.1, U26.3 (OUT); also elsewhere on the board
/Digital_IO_analog_Inputs/LEVEL_SWITCH: TP7.1, U17.3 (OUT); also elsewhere on the board
/Digital_IO_analog_Inputs/LEVEL_SWITCH_AC: D4.4, J5.2
/Digital_IO_analog_Inputs/SKIP_N_UNLOADED_BEEPER: R43.2; also elsewhere on the board
/Digital_IO_analog_Inputs/SKIP_N_UNLOADED_REL: R40.2; also elsewhere on the board
GNDREF: C48.2, C49.2, C50.2, C51.2, C52.2, C61.2, C69.2, C75.2, J3.1, J3.3, J3.5, J3.7, Q3.2 (E), Q4.2 (E), Q5.2 (E), Q6.2 (E), Q7.2 (E), U17.4 (GND1), U24.4 (GND1), U26.4 (GND1); also elsewhere on the board
unnamed: C51.1, C52.1, C69.1, C75.1, L3.2, U17.1 (VCC1), U17.2 (EN), U24.1 (VCC1), U24.2 (EN), U26.1 (VCC1), U26.2 (EN)
unnamed: D4.2, R23.2
unnamed: D6.1 (K), Q5.3 (C)
unnamed: D7.1 (K), Q6.3 (C)
unnamed: D7.2 (A), R29.2
unnamed: D8.2 (A), Q3.3 (C), RL1.8
unnamed: D9.1 (K), Q7.3 (C)
unnamed: D9.2 (A), R30.2
unnamed: J7.1, RL1.3, RL1.6
unnamed: J7.2, RL1.4, RL1.5
unnamed: J7.3, RL1.2, RL1.7
unnamed: LS1.2, Q4.3 (C)
unnamed: Q3.1 (B), R40.1
unnamed: Q4.1 (B), R43.1
unnamed: Q5.1 (B), R31.1
unnamed: Q6.1 (B), R32.1
unnamed: Q7.1 (B), R33.1
unnamed: R26.2, U17.7 (IN)
unnamed: R56.2, U24.7 (IN)
unnamed: R60.2, U26.7 (IN)
VDD_PER: L3.1; also elsewhere on the board

Notes on the sheet:
PE1
PD8
"Encoder A"
PF13
PF12
PA15
PB15
PB14
"PATH_SWITCH"
PE0
PB5
PB4
"Encoder B"
PC3_C

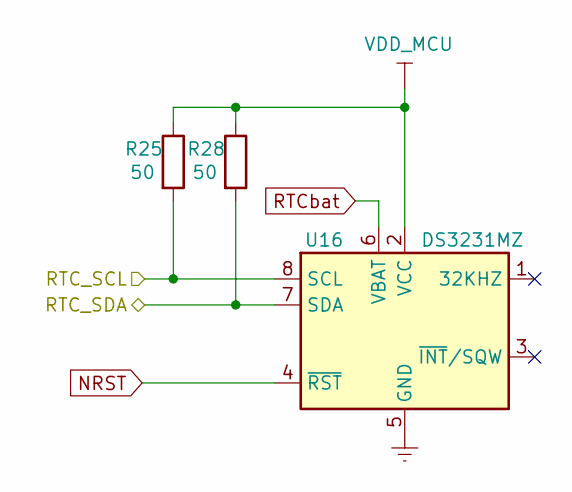
[picture p14: schematic RTC.kicad_sch]

Parts:
R25, R28: 50; R_0603_1608Metric_Pad0.98x0.95mm_HandSolder
U16: DS3231MZ; SOIC-8_3.9x4.9mm_P1.27mm

Connections:
/Microcontroller/RTC_SCL: R25.2, U16.8 (SCL); also elsewhere on the board
/Microcontroller/RTC_SDA: R28.2, U16.7 (SDA); also elsewhere on the board
GNDREF: U16.5 (GND); also elsewhere on the board
NRST: U16.4 (~RST); also elsewhere on the board
RTCbat: U16.6 (VBAT); also elsewhere on the board
VDD_MCU: R25.1, R28.1, U16.2 (VCC); also elsewhere on the board

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
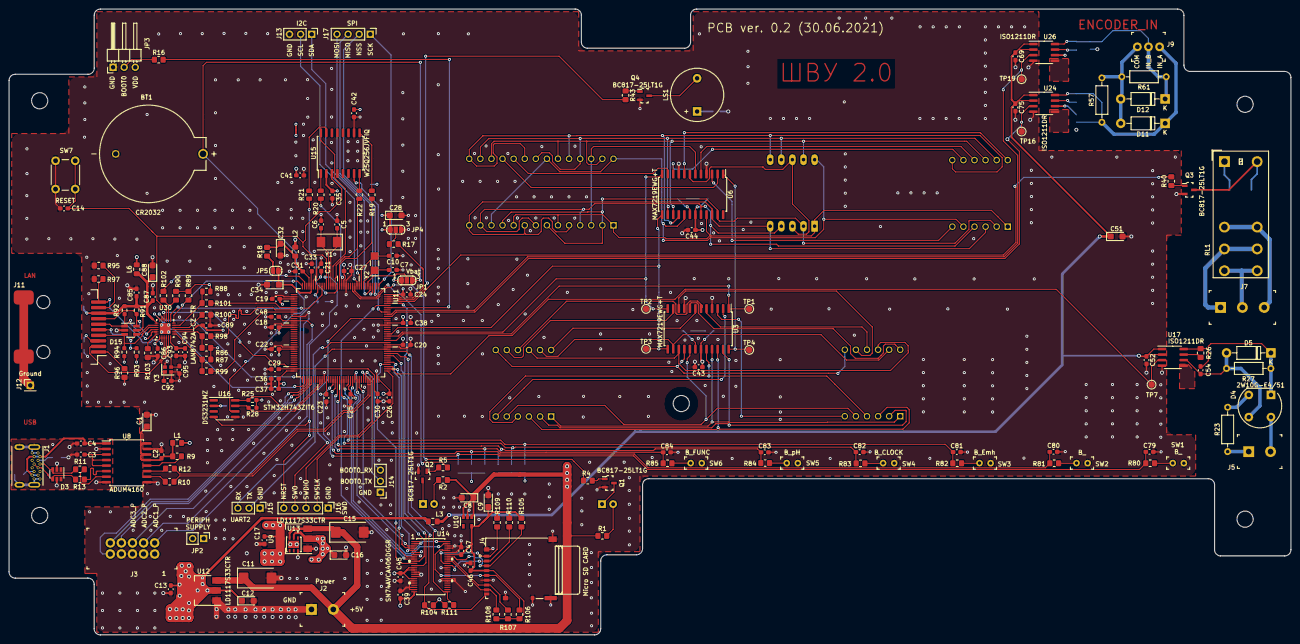
[picture p15: board Schema_and_PCB.kicad_pcb from above]

Board: 4 copper layers, 293.6 x 143.3 mm, 223 parts (0 on the bottom side), 196 nets.
