SVIELCOM/MWE_Schema_and_PCB/(commit log)

2021-05-07 Start with huge changes
    [Analog_and_digital_IO.sch, Indicator.sch, LAN.sch, MCU_Power.sch, MCU_Power_supply.sch, MCU_Power_supply_clocking.sch, Schema_and_PCB.kicad_pcb, Schema_and_PCB.sch]
2021-05-08 Added SD_Card Tranceiver TXS0206-29. Deleted2.9V LDO
    [MCU_Power_supply_clocking.sch, Storage_and_memory.sch]
2021-05-08 Restore 2.9V LDO
    [MCU_Power_supply_clocking.sch]
2021-05-08 QSPI and storage sheet finished
    [Storage_and_memory.sch]
2021-05-08 Indication edit
    [Indicator.sch, Schema_and_PCB.sch]
2021-05-09 Indication edit end
    [Indicator.sch, Schema_and_PCB.sch]
2021-05-12 start create Analog IO
    [Analog_and_digital_IO.sch, Indicator.sch, MCU_Power_supply_clocking.sch, Schema_and_PCB.sch]
2021-05-14 Analog Input edited
    [Analog_and_digital_IO.sch, Schema_and_PCB.sch]
2021-05-14 2.9V LDO changed
    [MCU_Power_supply_clocking.sch]
2021-05-17 Digital IO ended
    [Analog_and_digital_IO.sch, Indicator.sch]
2021-05-17 Created scheets Microcontroller, Main power, buttons
    [Analog_and_digital_IO.sch, Buttons.sch, Indicator.sch, LAN.sch, MCU_Power_supply_clocking.sch, Main_power.sch, Microcontroller.sch, Schema_and_PCB.sch]
2021-05-17 Buttons complete
    [Analog_and_digital_IO.sch, Indicator.sch, LAN.sch, MCU_Power_supply_clocking.sch, Schema_and_PCB.sch, Storage_and_memory.sch, U_USB.sch]
2021-05-17 analog IO MCU pin named
    [Analog_and_digital_IO.sch, Buttons.sch, Main_power.sch]
2021-05-17 begin MCU editing
    [Analog_and_digital_IO.sch, Buttons.sch, Indicator.sch, LAN.sch, MCU_Power_supply_clocking.sch, Microcontroller.sch, Schema_and_PCB.sch, Storage_and_memory.sch]
2021-05-18 Probably pre-alpha version is done
    [Buttons.sch, Microcontroller.sch, Schema_and_PCB.sch]
2021-05-19 v0.2 added ecoder inputs
    [Analog_and_digital_IO.sch, Buttons.sch, Microcontroller.sch, Schema_and_PCB.sch]
2021-05-19 v0.3 changed sd_card holder
    [Analog_and_digital_IO.sch, Buttons.sch, LAN.sch, MCU_Power_supply_clocking.sch, Microcontroller.sch, Schema_and_PCB.sch, Storage_and_memory.sch, U_USB.sch]
2021-05-20 footprints associations is done
    [Analog_and_digital_IO.sch, Buttons.sch, Indicator.sch, LAN.sch, MCU_Power_supply_clocking.sch, Microcontroller.sch, Schema_and_PCB.sch, Storage_and_memory.sch]
2021-05-21 board setup is done
    [Schema_and_PCB.kicad_pcb]
2021-05-21 board shape is done
    [Schema_and_PCB.kicad_pcb]
2021-05-21 LAN8742 footprint corrected
    [LAN.sch]
2021-05-23 starting PCB layout
    [Schema_and_PCB.kicad_pcb]
2021-05-24 corrected few footprints, correct all resistors and capacitors type for ordering
    [Analog_and_digital_IO.sch, Buttons.sch, Indicator.sch, LAN.sch, MCU_Power_supply_clocking.sch, Schema_and_PCB.csv, Schema_and_PCB.kicad_pcb, Schema_and_PCB.ods]
2021-05-25 corrected footprint for B82790C0225N265
    [Analog_and_digital_IO.sch, LAN.sch, Schema_and_PCB.kicad_pcb]
2021-05-25 PCB layout continue with SD_CARD interface TXS0206
    [Indicator.sch, Schema_and_PCB.kicad_pcb]
2021-05-26 deleted TXS0206 added SN74AVCA406DGGR and corrected schema for it
    [Analog_and_digital_IO.sch, Microcontroller.sch, Schema_and_PCB.sch, Storage_and_memory.sch]
2021-05-26 Prepare to move analog decoupling to standalone PCB
    [Analog_decoupling.sch, Main_power.sch, Schema_and_PCB.kicad_pcb]
2021-05-26 Create Analog decoupling PCB
    [Analog_decoupling.kicad_pcb]
2021-05-26 Analog decoupling PCB dimensions done
2021-05-26 Analog decoupling annotations and create netlist
    [Analog_decoupling.sch]
2021-05-26 Analog decoupling elements place to PCB
    [Analog_decoupling.kicad_pcb]
2021-05-26 Analog decoupling schema completed. Digital_IO completed and clean up
    [Analog_decoupling.sch, Digital_IO.sch, Digital_IO_analog_Inputs.sch, MCU_Power_supply_clocking.sch, Schema_and_PCB.sch]
2021-05-26 main PCB changes
    [Analog_decoupling.kicad_pcb, Schema_and_PCB.kicad_pcb]
2021-05-27 Footprints for pinheaders changed
    [LAN.sch, Microcontroller.sch, Schema_and_PCB.kicad_pcb]
2021-05-27 LAN elements placed
    [Digital_IO_analog_Inputs.sch, Schema_and_PCB.kicad_pcb, Storage_and_memory.sch]
2021-05-27 ISO1211 power supply apdated. Label USB_GND added
    [Digital_IO_analog_Inputs.sch, Schema_and_PCB.kicad_pcb, U_USB.sch]
2021-05-27 PCB autorouting attempt
    [MCU_Power_supply_clocking.sch, PCB.dsn, Schema_and_PCB.kicad_pcb, U_USB.sch]
2021-05-27 PCB drawing
    [LAN.sch, Schema_and_PCB.kicad_pcb]
2021-05-31 PCB layout
    [Buttons.sch, Digital_IO_analog_Inputs.sch, MCU_Power_supply_clocking.sch, Microcontroller.sch, Schema_and_PCB.kicad_pcb, U_USB.sch]
2021-05-31 Change ADC3 input chanel and pin
    [Schema_and_PCB.kicad_pcb]
2021-06-01 Indicators layout finished
    [Buttons.sch, Indicator.sch, Microcontroller.sch, PCB.dsn, Schema_and_PCB.kicad_pcb]
2021-06-01 Draft PCB done
    [Microcontroller.sch, Schema_and_PCB.kicad_pcb]
2021-06-01 PCB minor changes
    [Digital_IO_analog_Inputs.sch, MCU_Power_supply_clocking.sch, Microcontroller.sch, Schema_and_PCB.kicad_pcb]
2021-06-02 PCB before Gerber creating
    [Buttons.sch, Digital_IO_analog_Inputs.sch, MCU_Power_supply_clocking.sch, Microcontroller.sch, Schema_and_PCB.kicad_pcb, Storage_and_memory.sch]
2021-06-03 main PCB done. Gerbers sent to manufacturer
    [Schema_and_PCB-B_Adhes.gbr, Schema_and_PCB-B_Cu.gbr, Schema_and_PCB-B_Mask.gbr, Schema_and_PCB-B_Paste.gbr, Schema_and_PCB-B_SilkS.gbr, Schema_and_PCB-Edge_Cuts.gbr, Schema_and_PCB-F_Adhes.gbr, Schema_and_PCB-F_Cu.gbr]
2021-06-04 All vias changed
    [Schema_and_PCB-B_Adhes.gbr, Schema_and_PCB-B_Cu.gbr, Schema_and_PCB-B_Mask.gbr, Schema_and_PCB-B_Paste.gbr, Schema_and_PCB-B_SilkS.gbr, Schema_and_PCB-Edge_Cuts.gbr, Schema_and_PCB-F_Adhes.gbr, Schema_and_PCB-F_Cu.gbr]
2021-06-04 All mounting holes changed
    [Schema_and_PCB.kicad_pcb]
2021-06-04 PCB errors correcting
    [Schema_and_PCB-B_Adhes.gbr, Schema_and_PCB-B_Cu.gbr, Schema_and_PCB-B_Mask.gbr, Schema_and_PCB-B_Paste.gbr, Schema_and_PCB-B_SilkS.gbr, Schema_and_PCB-Edge_Cuts.gbr, Schema_and_PCB-F_Adhes.gbr, Schema_and_PCB-F_Cu.gbr]
2021-06-07 Main PCB layout done. Order sent to manufacturer
    [Schema_and_PCB-B_Mask.gbr, Schema_and_PCB-B_SilkS.gbr, Schema_and_PCB-Bottom.gbr, Schema_and_PCB-Edge_Cuts.gbr, Schema_and_PCB-F_Cu.gbr, Schema_and_PCB-F_Mask.gbr, Schema_and_PCB-F_SilkS.gbr, Schema_and_PCB-GND_Internal.gbr]
2021-06-08 Analog decoupling PCB layout done. Order sent to manufacturer
    [Analog_decoupling-B_Cu-BOTTOM.gbr, Analog_decoupling-B_Mask.gbr, Analog_decoupling-B_SilkS.gbr, Analog_decoupling-Edge_Cuts.gbr, Analog_decoupling-F_Cu-TOP.gbr, Analog_decoupling-F_Mask.gbr, Analog_decoupling-F_SilkS.gbr, Analog_decoupling-NPTH.drl]
2021-06-11 minor changes and add NRST to J16
    [Digital_IO_analog_Inputs.sch, Microcontroller.sch, Schema_and_PCB.kicad_pcb, Storage_and_memory.sch]
2021-06-17 SPI6 changed to SPI1
    [Indicator.sch, Microcontroller.sch, Schema_and_PCB.kicad_pcb, Schema_and_PCB.sch]
2021-06-29 Commit before correcting mistakes OA pinout in analog decoupling
    [Analog_decoupling.csv, Analog_decoupling.ods, Schema_and_PCB.csv, Schema_and_PCB.kicad_pcb, Schema_and_PCB.ods]
2021-06-30 OA pinout corrected. Mounting holes deleted
    [Analog_decoupling.kicad_pcb, Analog_decoupling.sch]
2021-06-30 All mistakes corrected
    [Analog_decoupling.kicad_pcb, MCU_Power_supply_clocking.sch, Schema_and_PCB.kicad_pcb]
2021-07-01 minor changes
    [LAN.sch, Schema_and_PCB.kicad_pcb, Storage_and_memory.sch]
2021-07-06 NRST to QSPI Flash Reset pin has been connected
    [Schema_and_PCB.kicad_pcb, Storage_and_memory.sch]
2021-10-04 Pined pin_1 U14
    [Schema_and_PCB.kicad_pcb]
2021-10-29 commit after KiCAD library updates
    [LAN.sch, Storage_and_memory.sch, U_USB.sch]
2021-11-18 ADC1 input changed from IN6 to IN2
    [Analog_decoupling.sch, Microcontroller.sch, Schema_and_PCB.kicad_pcb]
2021-11-19 More GND vias
    [Schema_and_PCB.kicad_pcb]
2021-11-19 RTC sheet added
    [Buttons.sch, Digital_IO_analog_Inputs.sch, Indicator.sch, LAN.sch, MCU_Power_supply_clocking.sch, Microcontroller.sch, RTC.sch, Schema_and_PCB.sch]
2021-11-19 RTC DS3231 layot finished
    [MCU_Power_supply_clocking.sch, Microcontroller.sch, RTC.sch, Schema_and_PCB.kicad_pcb, Schema_and_PCB.sch]
2021-11-22 USART2 connector connectings redrawed
    [Schema_and_PCB.kicad_pcb]
2021-11-22 Some GND vias added
    [Schema_and_PCB.kicad_pcb]
2021-12-13 ADC2 in changed to IN5
    [Microcontroller.sch, Schema_and_PCB.kicad_pcb]
2022-01-18 KiCAD 6 firs saves
    [Buttons.kicad_sch, Digital_IO_analog_Inputs.kicad_sch, Indicator.kicad_sch, LAN.kicad_sch, MCU_Power_supply_clocking.kicad_sch, Microcontroller.kicad_sch, RTC.kicad_sch, Schema_and_PCB.kicad_sch]
2022-02-11 KiCAD6.0 scheema rules check done
    [Buttons.kicad_sch, Digital_IO_analog_Inputs.kicad_sch, Indicator.kicad_sch, LAN.kicad_sch, MCU_Power_supply_clocking.kicad_sch, Schema_and_PCB.kicad_sch, Storage_and_memory.kicad_sch, U_USB.kicad_sch]
2022-02-11 KiCAD6.0 PCB rules check done
2022-02-11 digital inputs refactoring
    [Digital_IO_analog_Inputs.kicad_sch, Schema_and_PCB.kicad_sch]
2022-02-11 Indication LEDs added
    [Digital_IO_analog_Inputs.kicad_sch, MCU_Power_supply_clocking.kicad_sch, Schema_and_PCB.kicad_sch]
2022-02-11 PCB ver. 0.3
    [Schema_and_PCB.kicad_sch, Storage_and_memory.kicad_sch]
2022-02-20 State before converting analog docoupling scheema to KiCAD6.0 format
2022-02-21 Analog decoupling scheema converted to KiCAD6 format. Added LDOs for ISO224. Added power LEDs
    [Analog_decoupling.kicad_sch, DoNotPrint.kicad_sch]
2022-02-21 Analog decoupling PCB converted to KiCAD6 format and pass DRC
    [Analog_decoupling.kicad_pcb]
2022-02-22 Analog decoupling PCB added LDOs for ISO224, added power LEDs
    [Analog_decoupling.kicad_pcb]
2022-02-22 Analog decoupling PCB J4 and J5 moved to left edge
    [Analog_decoupling.kicad_pcb]
2022-03-23 GPIO port changed for input signals
    [Analog_decoupling.kicad_pcb, Analog_decoupling.kicad_sch, DoNotPrint.kicad_sch, MCU_Power_supply_clocking.kicad_sch, Microcontroller.kicad_sch, Schema_and_PCB.kicad_sch, Storage_and_memory.kicad_sch]
2022-03-24 External connectors sheet added
    [External IO connectors.kicad_sch, Microcontroller.kicad_sch, Schema_and_PCB.kicad_sch, Storage_and_memory.kicad_sch]
2022-03-24 Skip unload COM signal of external connector corrected
    [External IO connectors.kicad_sch]
2022-03-24 CPU programming external connector added
    [External IO connectors.kicad_sch, Schema_and_PCB.kicad_sch]
2022-07-25 All handsolder footprints removed
    [Buttons.kicad_sch, Digital_IO_analog_Inputs.kicad_sch, External IO connectors.kicad_sch, Indicator.kicad_sch, LAN.kicad_sch, MCU_Power_supply_clocking.kicad_sch, Schema_and_PCB.kicad_sch, Storage_and_memory.kicad_sch]
